milanovviktorio/harbor-measuring-device-SPRO3/README.md

# harbor-measuring-device-SPRO3
SPRO3, SDU Electronics
