milanovviktorio/harbor-measuring-device-SPRO3/Hardware/ESC and BMS/ESC_BMS/DXF_ESCBMS.dxf

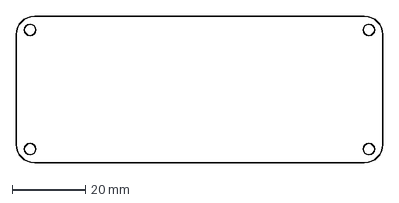
[picture p1: CAD file, 2025-11-08]
Hardware/ESC and BMS/ESC_BMS/DXF_ESCBMS.dxf
100.0 x 40.0 mm
