milanovviktorio/harbor-measuring-device-SPRO3/Hardware/Main_PCB/UJC-HP-3-SMT-TR.step

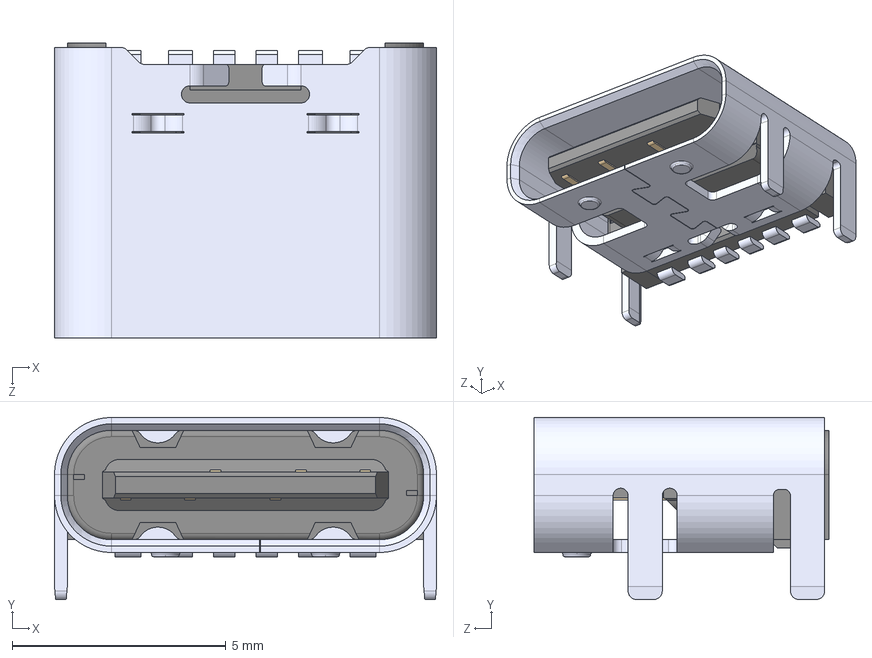
[picture p2: CAD file, 2025-11-06]
Hardware/Main_PCB/UJC-HP-3-SMT-TR.step
8.94 x 4.26 x 6.90 mm
