milanovviktorio/harbor-measuring-device-SPRO3/Hardware/Main_PCB/SRR6038-100Y.step

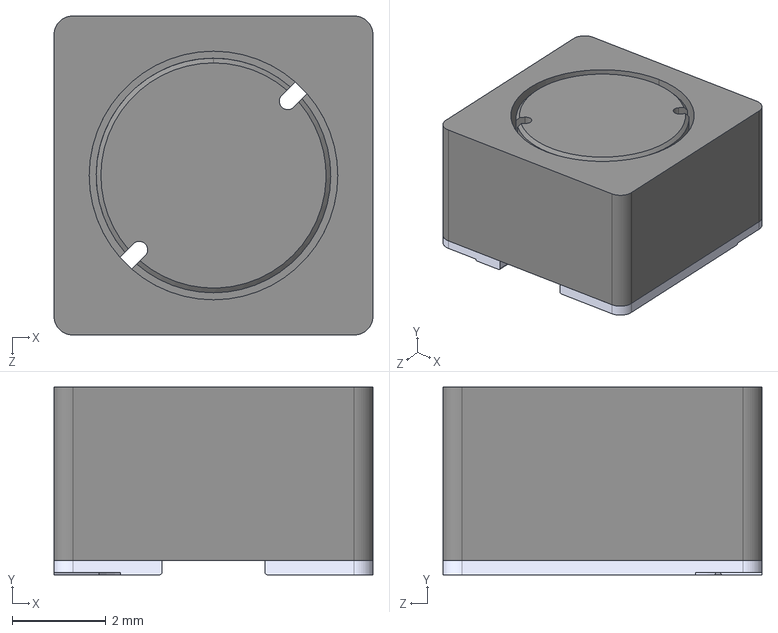
[picture p3: CAD file, 2025-10-28]
Hardware/Main_PCB/SRR6038-100Y.step
6.80 x 4.00 x 6.80 mm
