milanovviktorio/harbor-measuring-device-SPRO3/Hardware/Main_PCB/ICM-42688-P.step

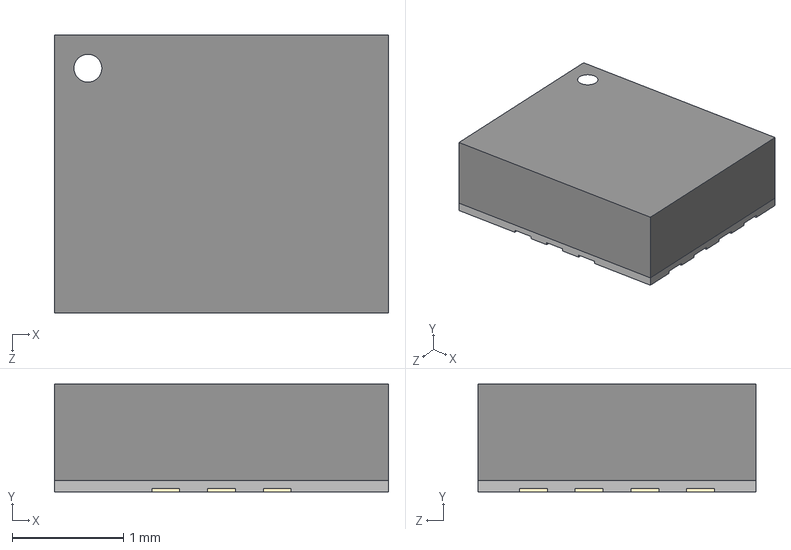
[picture p4: CAD file, 2025-10-21]
Hardware/Main_PCB/ICM-42688-P.step
3.00 x 0.97 x 2.50 mm
