milanovviktorio/harbor-measuring-device-SPRO3/Hardware/Main_PCB/TUSS4470TRTJT.step

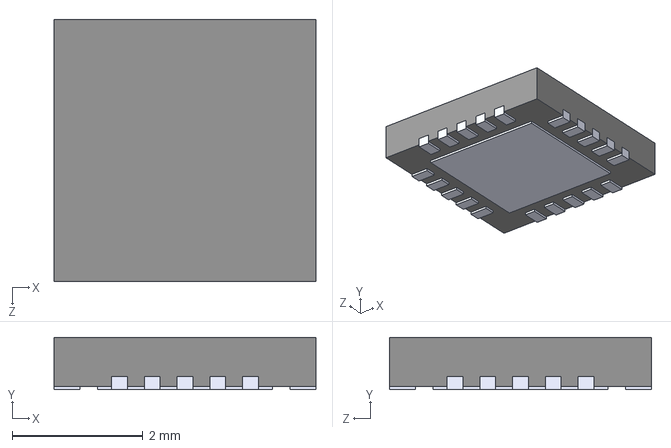
[picture p5: CAD file, 2025-10-21]
Hardware/Main_PCB/TUSS4470TRTJT.step
4.00 x 0.8 x 4.00 mm
