milanovviktorio/harbor-measuring-device-SPRO3/Hardware/Main_PCB/TPS61175PWPR.step

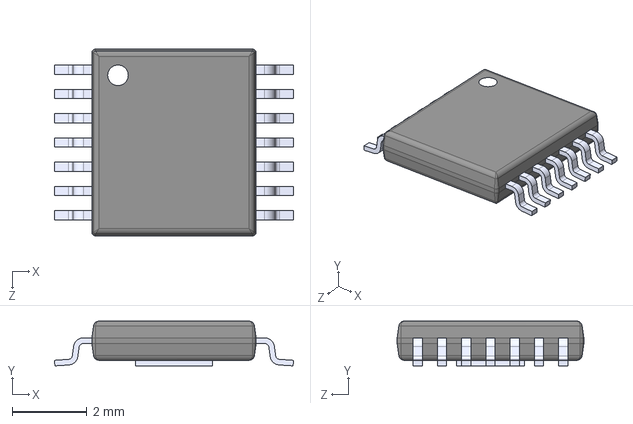
[picture p6: CAD file, 2025-10-22]
Hardware/Main_PCB/TPS61175PWPR.step
6.40 x 1.20 x 5.00 mm
