milanovviktorio/harbor-measuring-device-SPRO3/Hardware/ESC and BMS/ESC_BMS/SPROJ3EE_ESC_BMS.pdf

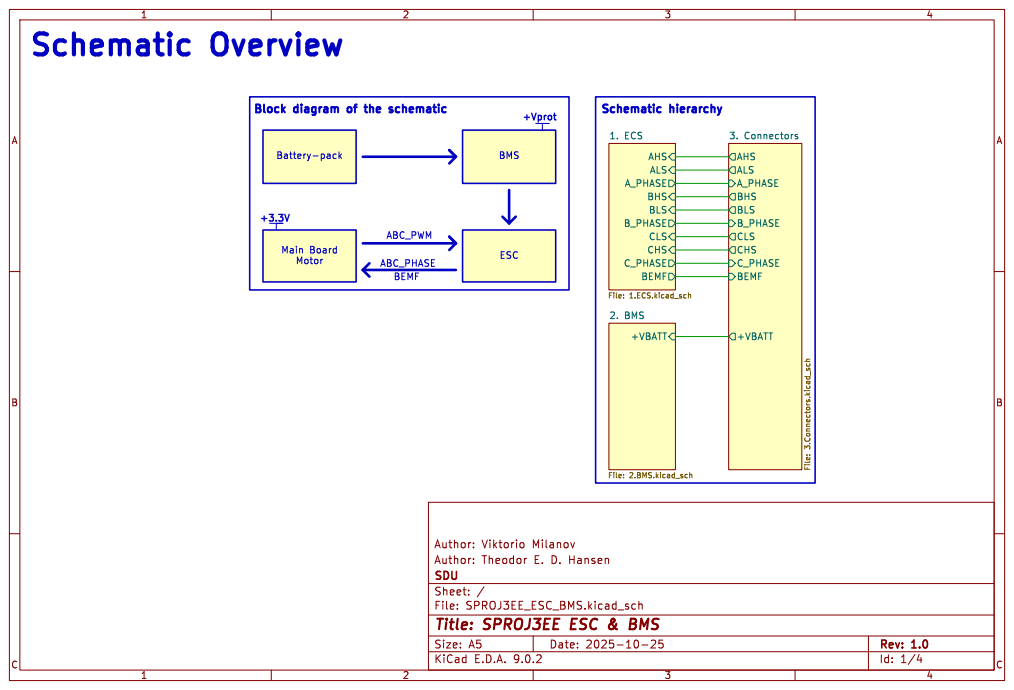
[picture p7: page 1]

Id: 1/4 Title: SPROJ3EE ESC & BMS

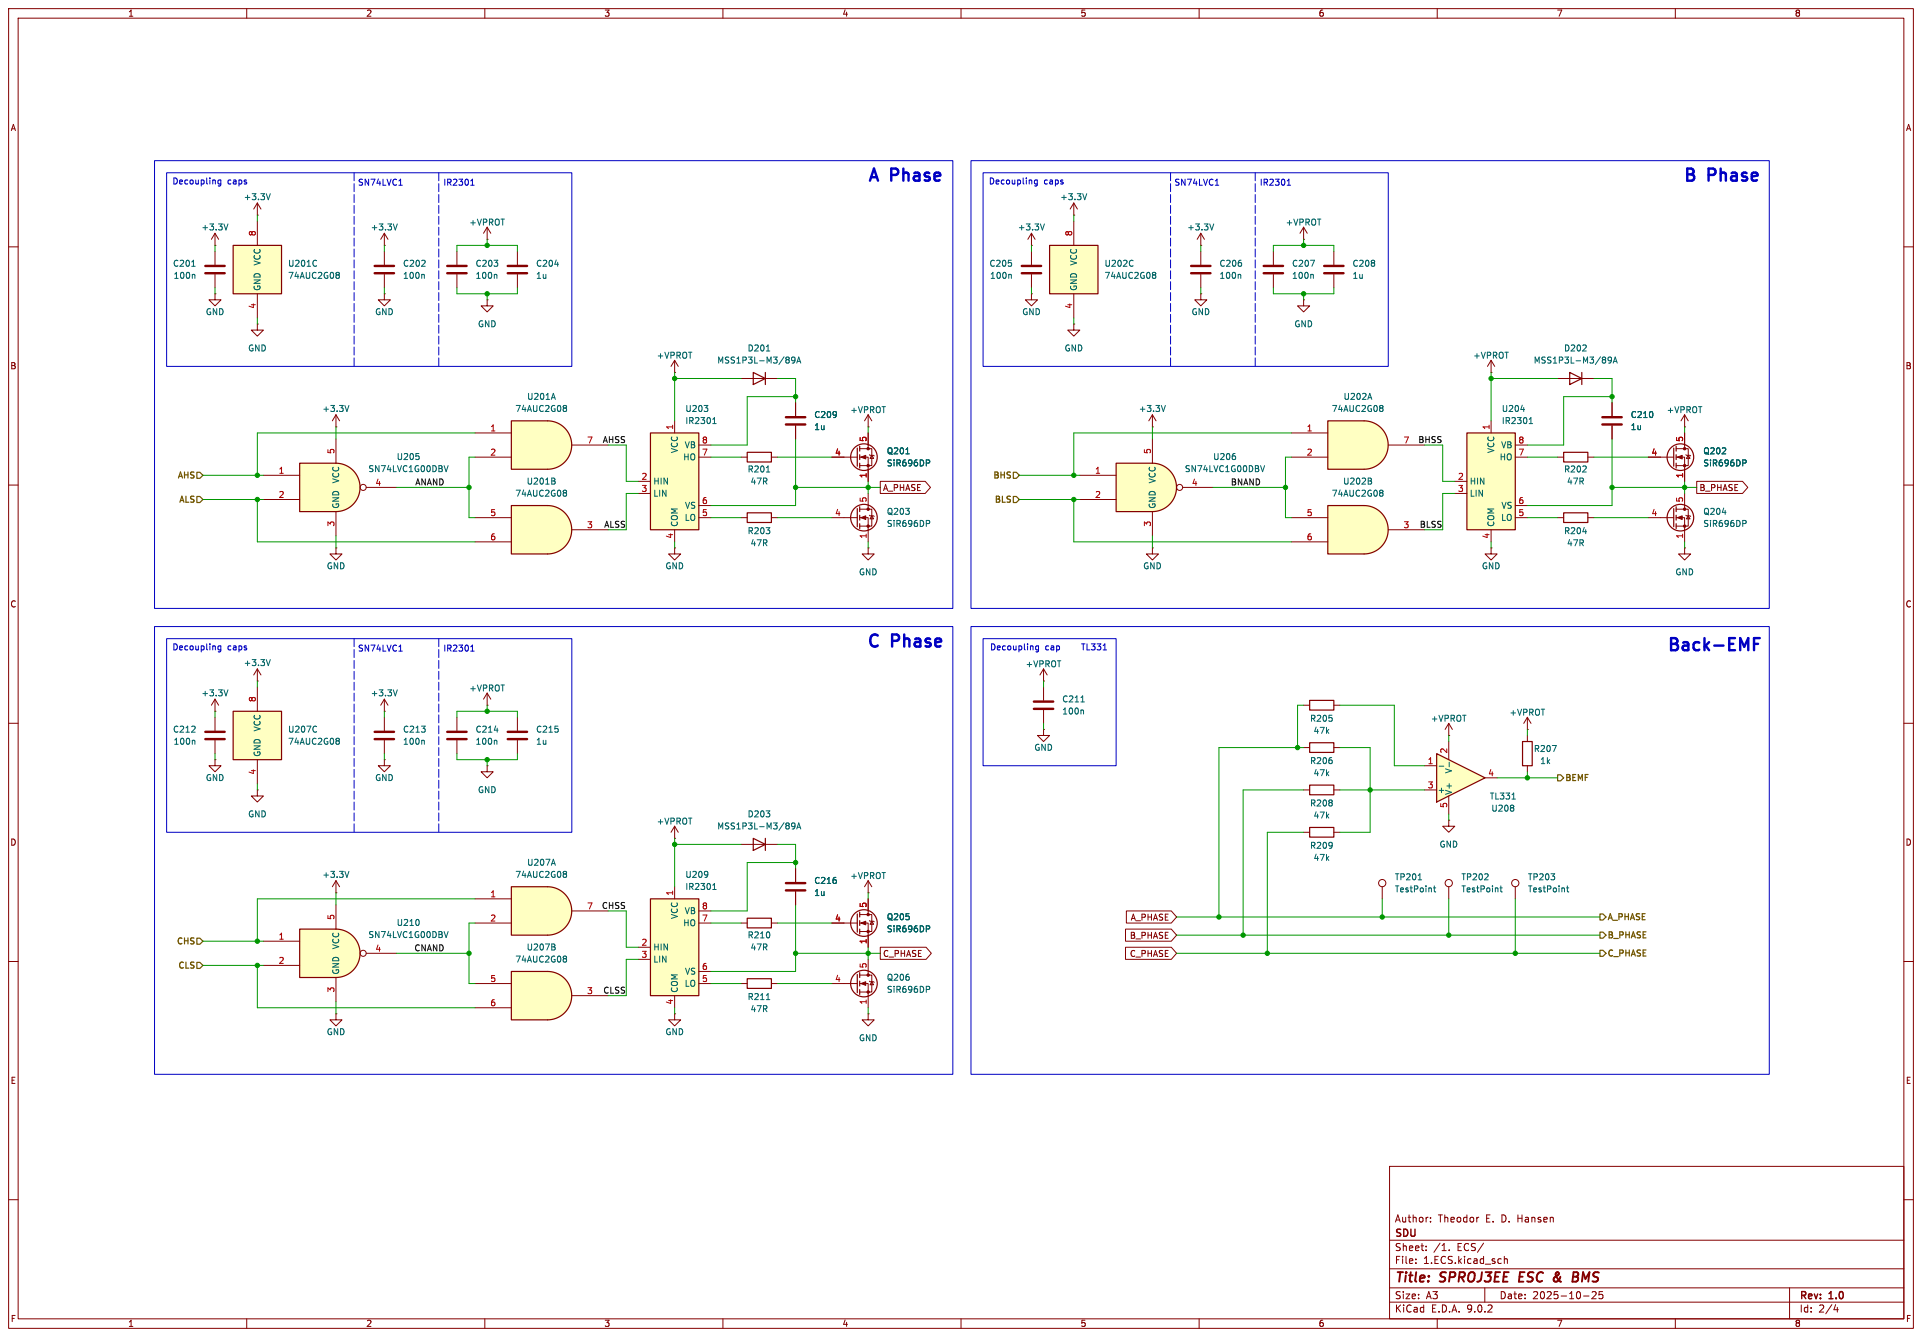
[picture p8: page 2]

Id: 2/4 Title: SPROJ3EE ESC & BMS

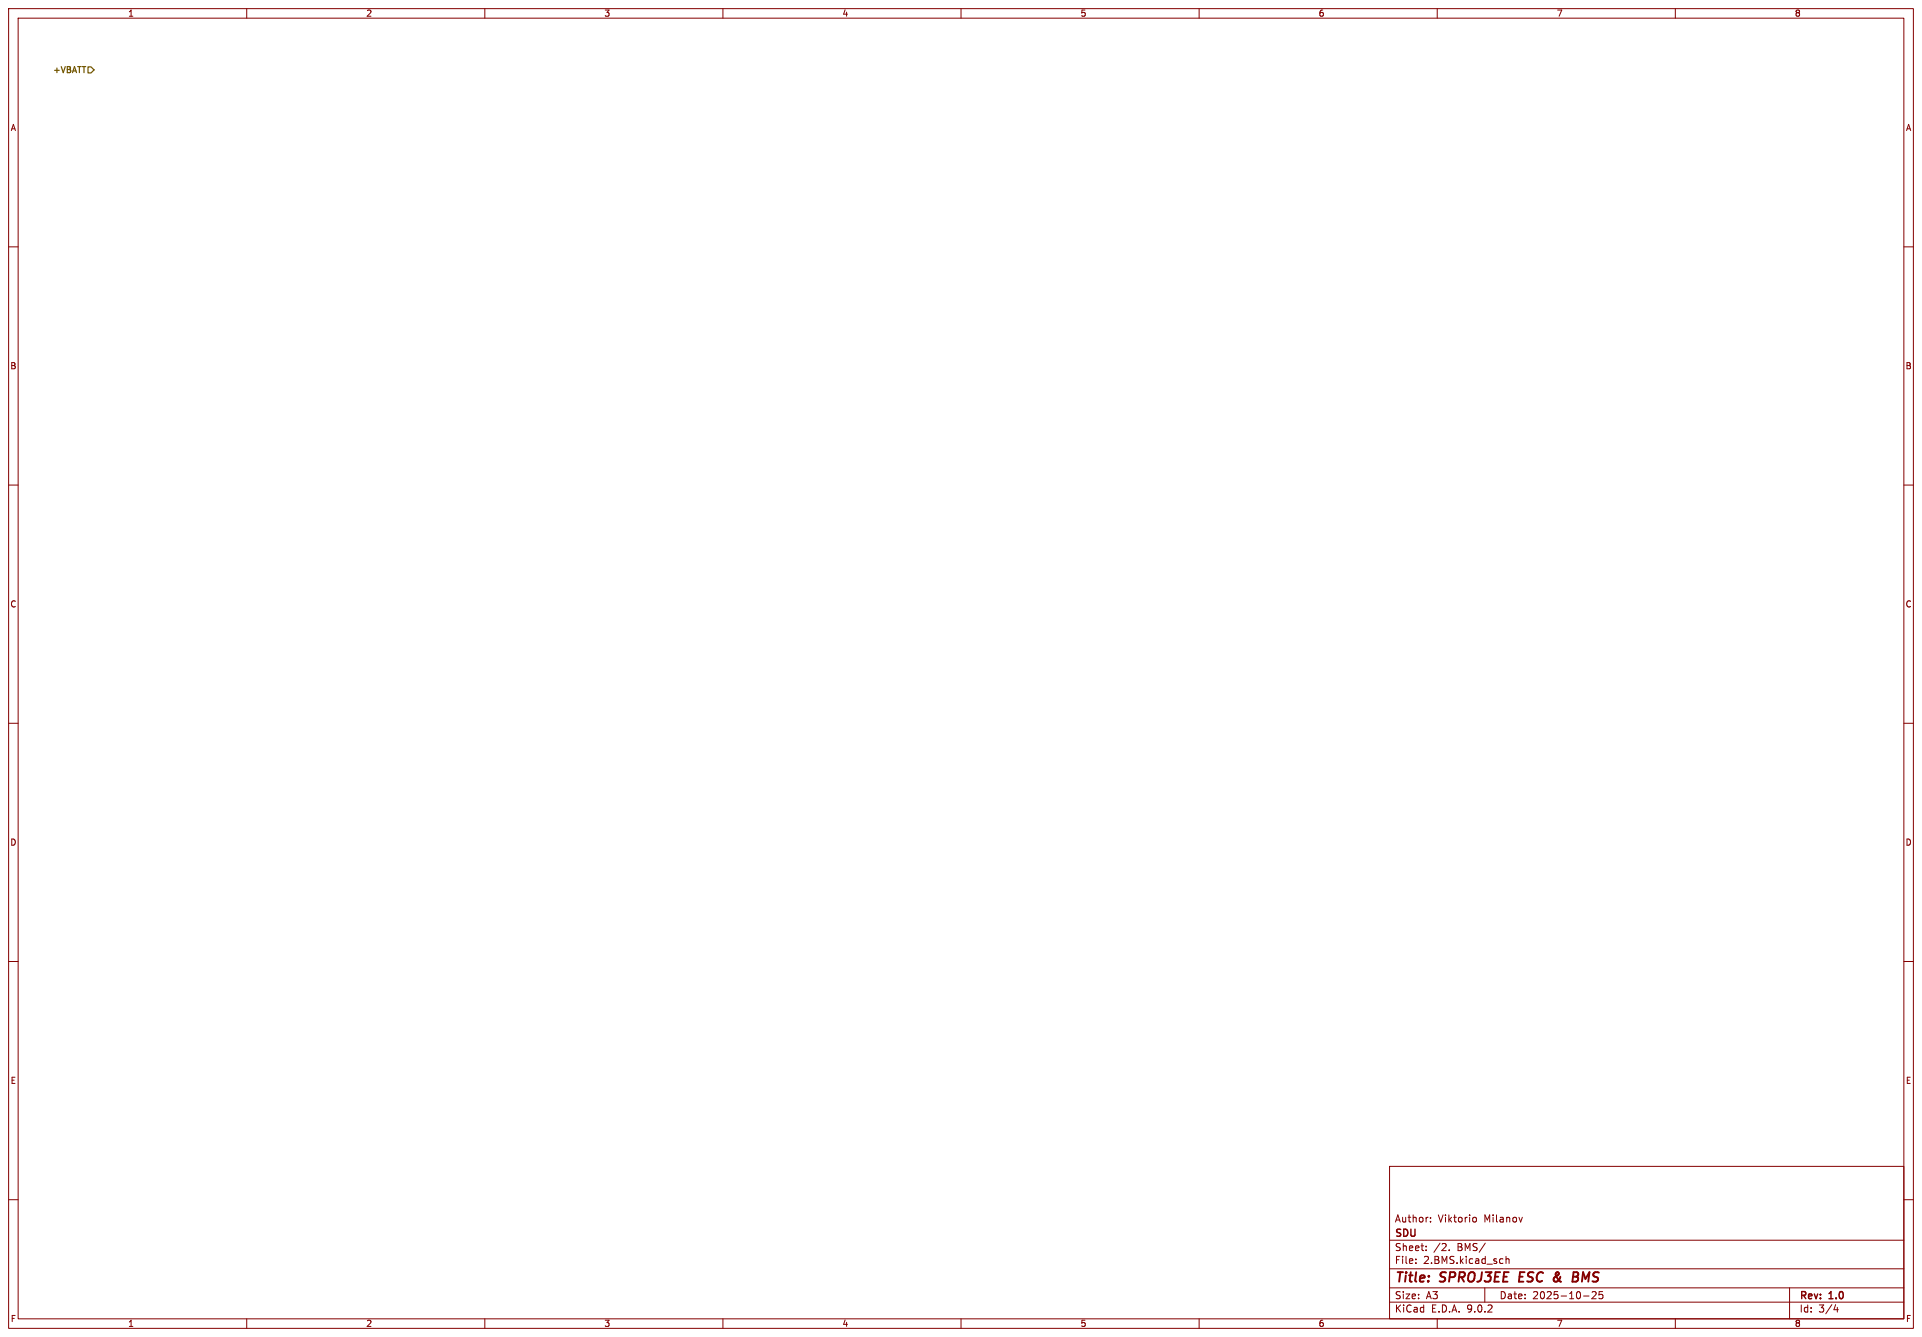
[picture p9: page 3]

Id: 3/4 Title: SPROJ3EE ESC & BMS

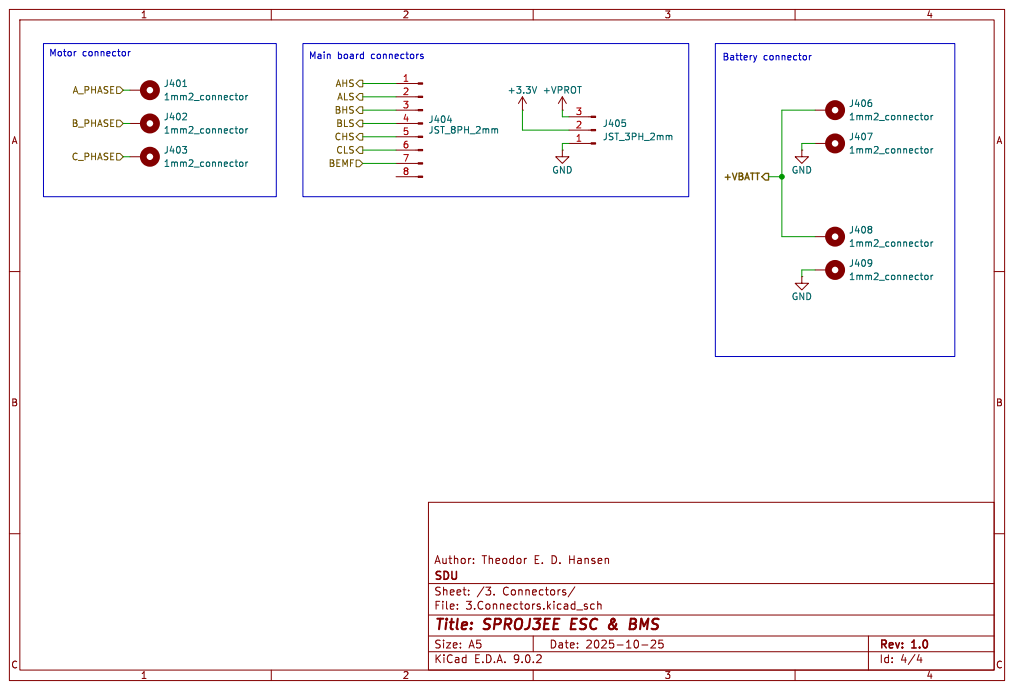
[picture p10: page 4]

File: 3.Connectors.kicad_sch Sheet: /3. Connectors/ SDU

Id: 4/4 Title: SPROJ3EE ESC & BMS
