milanovviktorio/harbor-measuring-device-SPRO3/Simulations/ESC_BMS/RPP/Draft1.asc

C1: cap; 5.3052µ
R1: res; 100
V1: voltage; ""; AC 5
Named nets: 0
.ac oct 100 1 1e9
