milanovviktorio/harbor-measuring-device-SPRO3/Simulations/ESC_BMS/RPP/Rpp.asc

C1: cap; 100n
D1: zener
M1: pmos
R1: res; 27k
V1: voltage; -8.4
Named nets: 0, Vout, Vin
.tran 0 1 0 0.01
