milanovviktorio/harbor-measuring-device-SPRO3/(list of files, drawings)

Other design files:
Simulations/ESC_BMS/SLVMB85A/TPS259260_PSPICE_TRANS/TPS259260_TRANS.DSN
Simulations/ESC_BMS/SLVMB85A/TPS259260_PSPICE_TRANS/TPS259260_TRANS.OPJ
Simulations/ESC_BMS/SLVMB85A/TPS259260_PSPICE_TRANS/TPS259260DRC_TRANS.OLB
