milanovviktorio/harbor-measuring-device-SPRO3/Hardware/RC thing/RC thing.kicad_pcb

## KiCad design Hardware/RC thing/RC thing.kicad_pcb (2025-11-18)

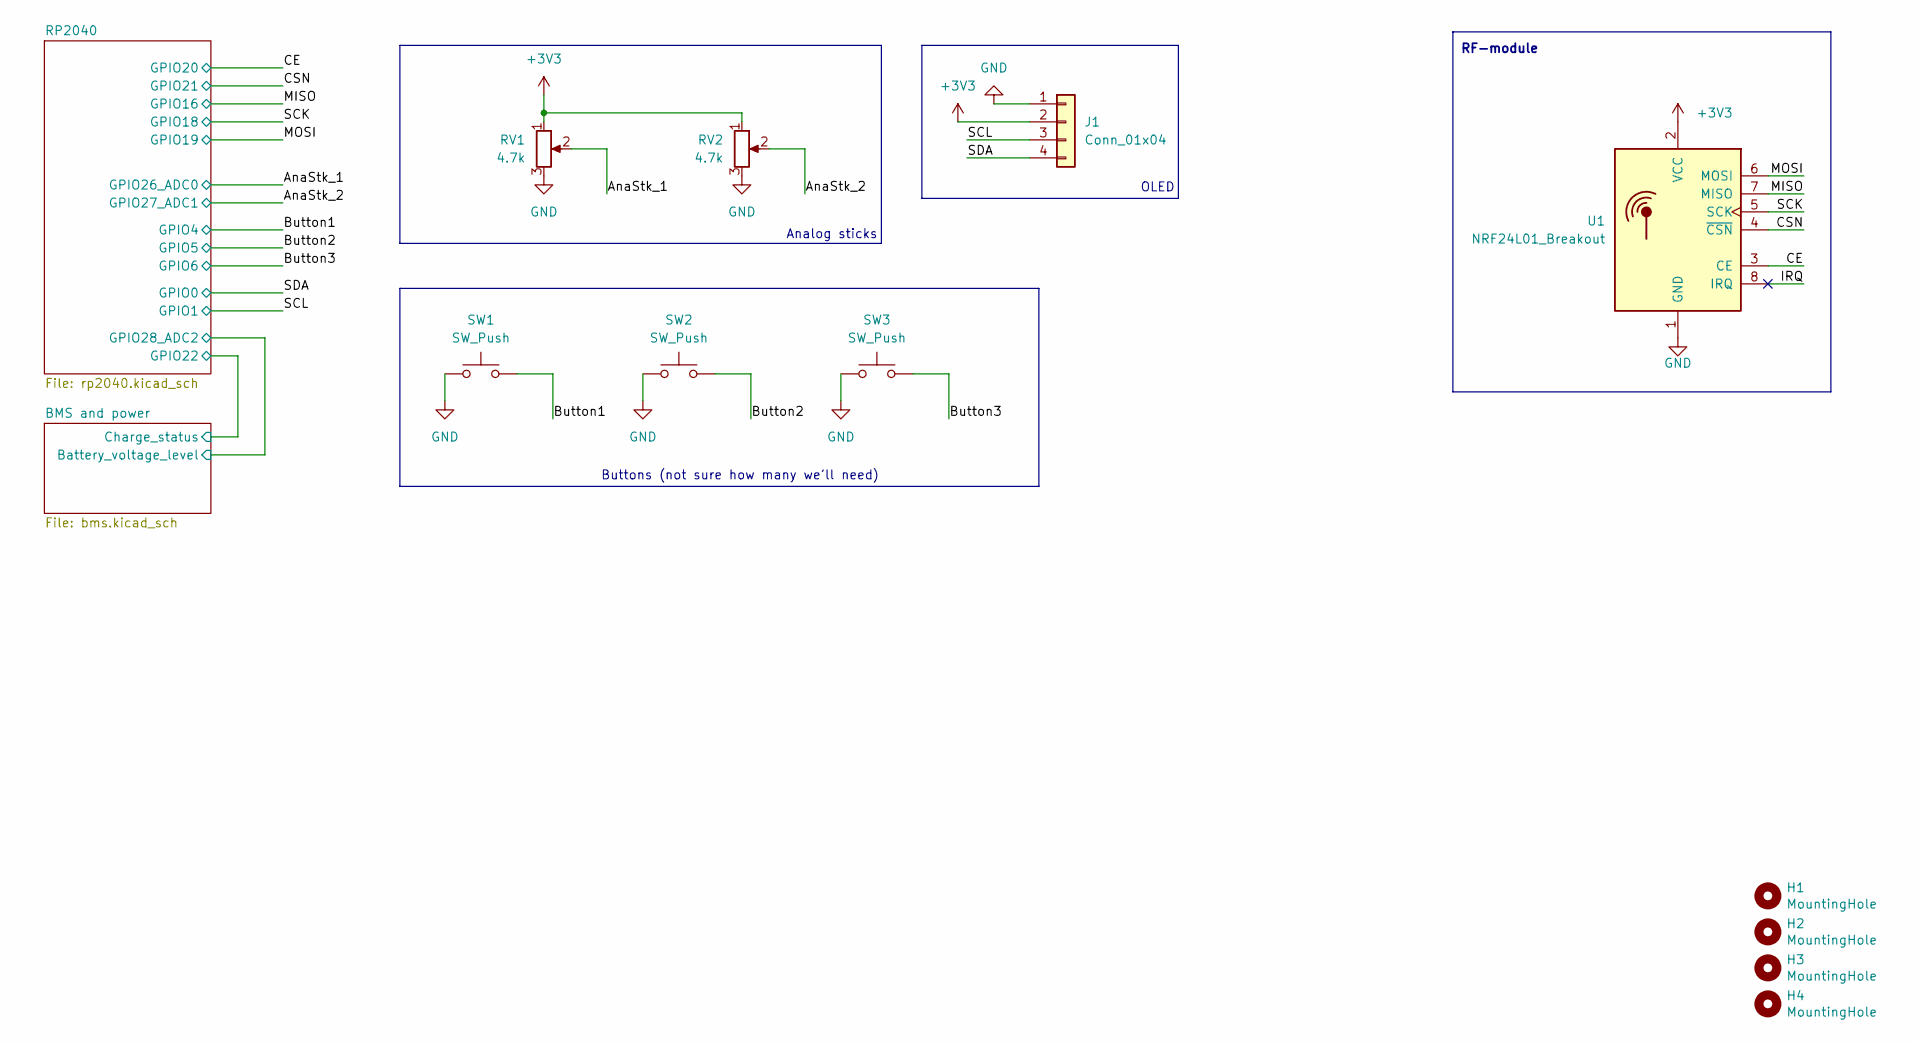
[picture p11: schematic RC thing.kicad_sch, SPRO3D RC remote PCB]

Parts:
H1, H2, H3, H4: MountingHole; MountingHole_2.7mm_M2.5
J1: Conn_01x04; JST_PH_B4B-PH-K_1x04_P2.00mm_Vertical
RV1, RV2: 4.7k; JST_PH_B3B-PH-K_1x03_P2.00mm_Vertical
SW1, SW2, SW3: SW_Push; JST_PH_B2B-PH-K_1x02_P2.00mm_Vertical
U1: NRF24L01_Breakout; PinHeader_2x04_P2.54mm_Vertical

Connections:
+3V3: J1.2, RV1.1, RV2.1, U1.2 (VCC); also elsewhere on the board
/AnaStk_1: RV1.2; also elsewhere on the board
/AnaStk_2: RV2.2; also elsewhere on the board
/Button1: SW1.2; also elsewhere on the board
/Button2: SW2.2; also elsewhere on the board
/Button3: SW3.2; also elsewhere on the board
/CE: U1.3 (CE); also elsewhere on the board
/CSN: U1.4 (~CSN); also elsewhere on the board
/IRQ: U1.8 (IRQ)
/MISO: U1.7 (MISO); also elsewhere on the board
/MOSI: U1.6 (MOSI); also elsewhere on the board
/SCK: U1.5 (SCK); also elsewhere on the board
/SCL: J1.3; also elsewhere on the board
/SDA: J1.4; also elsewhere on the board
GND: J1.1, RV1.3, RV2.3, SW1.1, SW2.1, SW3.1, U1.1 (GND); also elsewhere on the board

Notes on the sheet:
Buttons (not sure how many we'll need)
RF-module
OLED
Analog sticks

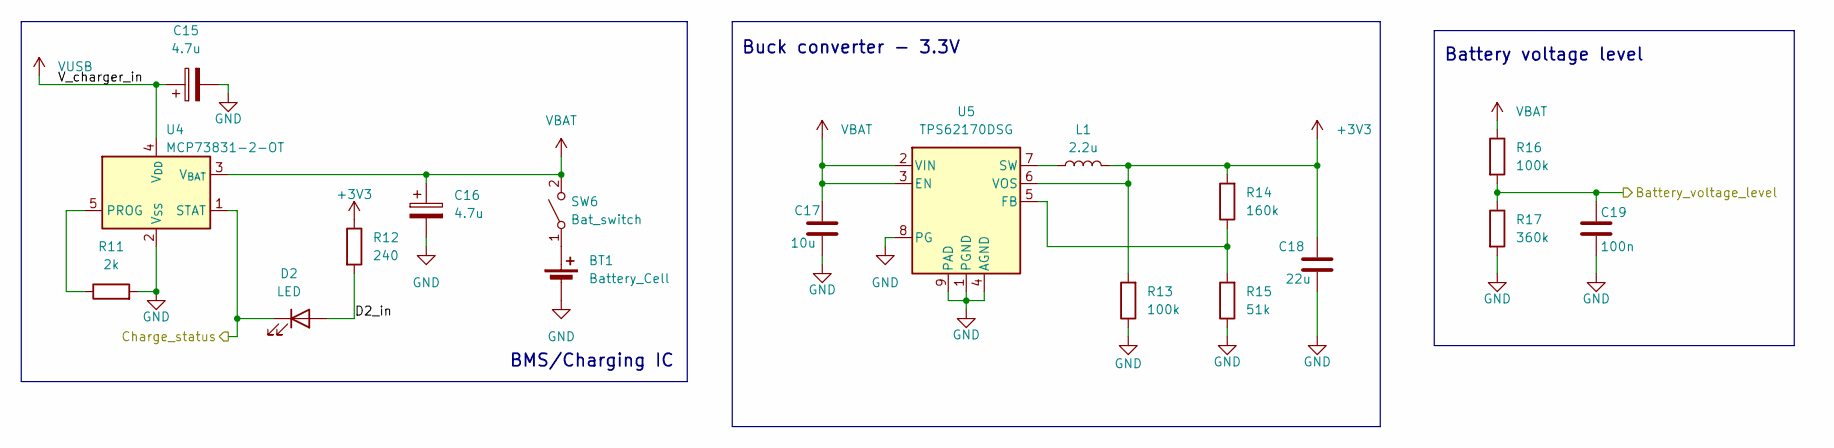
[picture p12: schematic bms.kicad_sch]

Parts:
BT1: Battery_Cell; JST_PH_B2B-PH-K_1x02_P2.00mm_Vertical
C15, C16: 4.7u; C_0805_2012Metric_Pad1.18x1.45mm_HandSolder
C17: 10u; C_0805_2012Metric_Pad1.18x1.45mm_HandSolder
C18: 22u; C_0805_2012Metric_Pad1.18x1.45mm_HandSolder
C19: 100n; C_0603_1608Metric_Pad1.08x0.95mm_HandSolder
D2: LED; D_0603_1608Metric_Pad1.05x0.95mm_HandSolder
L1: 2.2u; L_APV_ANR252012
R11: 2k; R_0603_1608Metric_Pad0.98x0.95mm_HandSolder
R12: 240; R_0603_1608Metric_Pad0.98x0.95mm_HandSolder
R13, R16: 100k; R_0603_1608Metric_Pad0.98x0.95mm_HandSolder
R14: 160k; R_0603_1608Metric_Pad0.98x0.95mm_HandSolder
R15: 51k; R_0603_1608Metric_Pad0.98x0.95mm_HandSolder
R17: 360k; R_0603_1608Metric_Pad0.98x0.95mm_HandSolder
SW6: Bat_switch; JST_PH_B2B-PH-K_1x02_P2.00mm_Vertical
U4: MCP73831-2-OT; SOT-23-5
U5: TPS62170DSG; WSON-8-1EP_2x2mm_P0.5mm_EP0.9x1.6mm_ThermalVias

Connections:
+3V3: C18.1, L1.2, R12.1, R13.2, R14.2, U5.6 (VOS); also elsewhere on the board
/BMS and power/D2_in: D2.2 (A), R12.2
/RP2040/GPIO22: D2.1 (K), U4.1 (STAT); also elsewhere on the board
/RP2040/GPIO28_ADC2: C19.1, R16.2, R17.1; also elsewhere on the board
GND: BT1.2 (-), C15.2, C16.2, C17.2, C18.2, C19.2, R11.2, R13.1, R15.1, R17.2, U4.2 (V_{SS}), U5.1 (PGND), U5.4 (AGND), U5.8 (PG), U5.9 (PAD); also elsewhere on the board
unnamed: BT1.1 (+), SW6.1 (A)
unnamed: R11.1, U4.5 (PROG)
unnamed: R14.1, R15.2, U5.5 (FB)
unnamed: L1.1, U5.7 (SW)
VBAT: C16.1, C17.1, R16.1, SW6.2 (B), U4.3 (V_{BAT}), U5.2 (VIN), U5.3 (EN)
VUSB: C15.1, U4.4 (V_{DD}); also elsewhere on the board

Notes on the sheet:
BMS/Charging IC
Battery voltage level
Buck converter - 3.3V

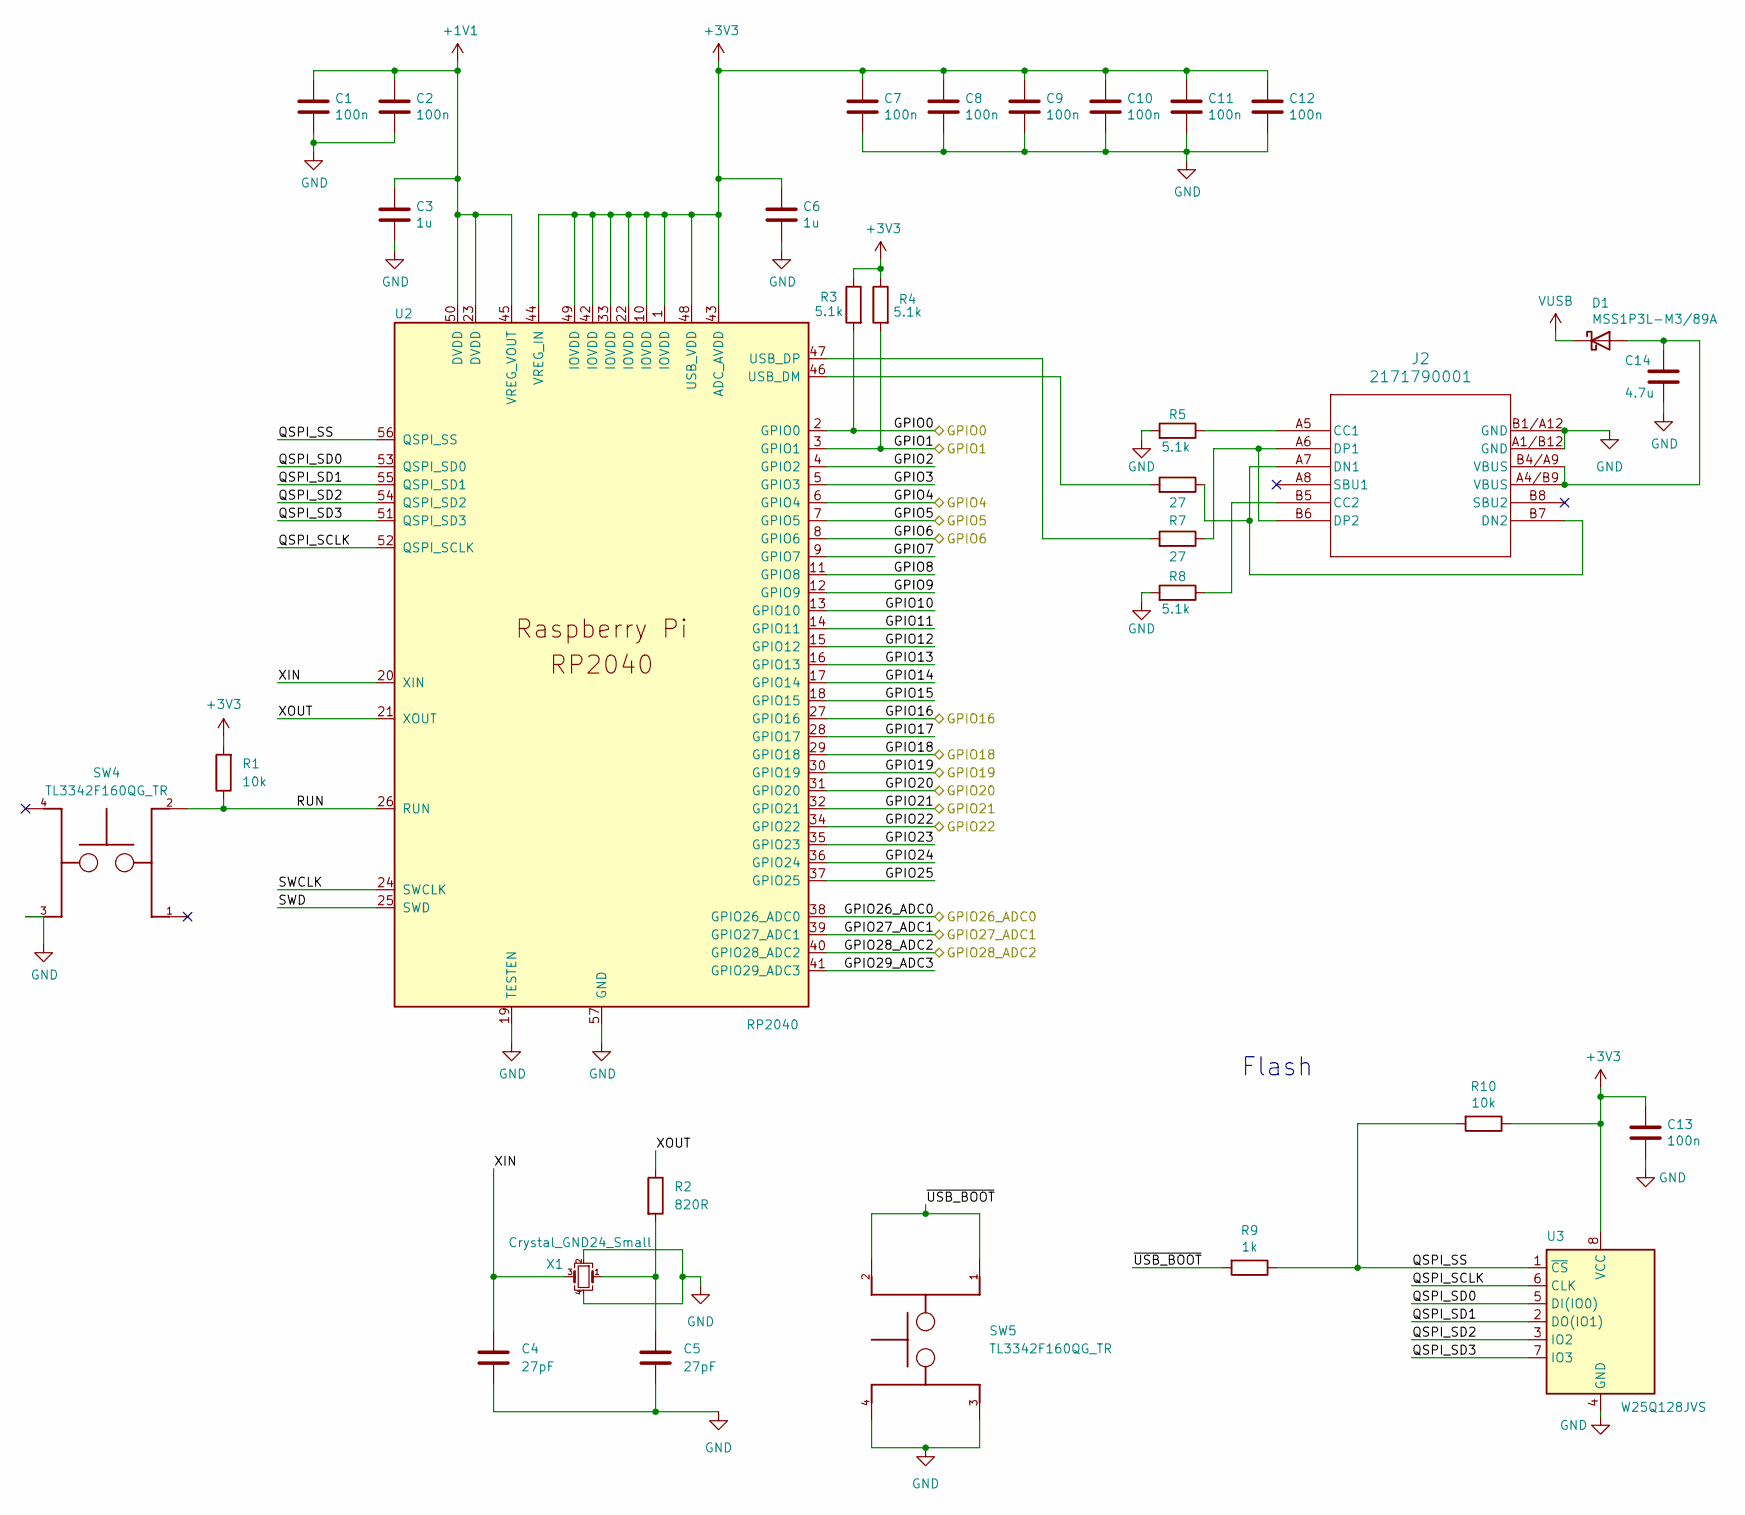
[picture p13: schematic rp2040.kicad_sch, RP2040 Minimal Design Example]

Parts:
C1, C2, C7, C8, C9, C10, C11, C12, C13: 100n; C_0603_1608Metric_Pad1.08x0.95mm_HandSolder
C3, C6: 1u; C_0603_1608Metric_Pad1.08x0.95mm_HandSolder
C4, C5: 27pF; C_0603_1608Metric_Pad1.08x0.95mm_HandSolder
C14: 4.7u; C_0603_1608Metric_Pad1.08x0.95mm_HandSolder
D1: MSS1P3L-M3/89A; Vishay_SMPA
J2: 2171790001; 2171790001_MOL
R1: 10k; C_0603_1608Metric_Pad1.08x0.95mm_HandSolder
R2: 820R; R_0603_1608Metric_Pad0.98x0.95mm_HandSolder
R3, R4, R5, R8: 5.1k; R_0603_1608Metric_Pad0.98x0.95mm_HandSolder
R6, R7: 27; R_0603_1608Metric_Pad0.98x0.95mm_HandSolder
R9: 1k; R_0603_1608Metric_Pad0.98x0.95mm_HandSolder
R10: 10k; R_0603_1608Metric_Pad0.98x0.95mm_HandSolder
SW4, SW5: TL3342F160QG_TR; SW_TL3342F160QG_TR
U2: RP2040; QFN-56-1EP_7x7mm_P0.4mm_EP3.2x3.2mm
U3: W25Q128JVS; SOIC-8_5.3x5.3mm_P1.27mm
X1: Crystal_GND24_Small; Crystal_SMD_Abracon_ABM8G-4Pin_3.2x2.5mm

Connections:
+1V1: C1.1, C2.1, C3.1, U2.23 (DVDD), U2.45 (VREG_VOUT), U2.50 (DVDD)
+3V3: C6.1, C7.1, C8.1, C9.1, C10.1, C11.1, C12.1, C13.1, R1.2, R3.1, R4.1, R10.1, U2.1 (IOVDD), U2.10 (IOVDD), U2.22 (IOVDD), U2.33 (IOVDD), U2.42 (IOVDD), U2.43 (ADC_AVDD), U2.44 (VREG_IN), U2.48 (USB_VDD), U2.49 (IOVDD), U3.8 (VCC); also elsewhere on the board
/AnaStk_1: U2.38 (GPIO26_ADC0); also elsewhere on the board
/AnaStk_2: U2.39 (GPIO27_ADC1); also elsewhere on the board
/Button1: U2.6 (GPIO4); also elsewhere on the board
/Button2: U2.7 (GPIO5); also elsewhere on the board
/Button3: U2.8 (GPIO6); also elsewhere on the board
/CE: U2.31 (GPIO20); also elsewhere on the board
/CSN: U2.32 (GPIO21); also elsewhere on the board
/MISO: U2.27 (GPIO16); also elsewhere on the board
/MOSI: U2.30 (GPIO19); also elsewhere on the board
/RP2040/GPIO2: U2.4 (GPIO2)
/RP2040/GPIO3: U2.5 (GPIO3)
/RP2040/GPIO7: U2.9 (GPIO7)
/RP2040/GPIO8: U2.11 (GPIO8)
/RP2040/GPIO9: U2.12 (GPIO9)
/RP2040/GPIO10: U2.13 (GPIO10)
/RP2040/GPIO11: U2.14 (GPIO11)
/RP2040/GPIO12: U2.15 (GPIO12)
/RP2040/GPIO13: U2.16 (GPIO13)
/RP2040/GPIO14: U2.17 (GPIO14)
/RP2040/GPIO15: U2.18 (GPIO15)
/RP2040/GPIO17: U2.28 (GPIO17)
/RP2040/GPIO22: U2.34 (GPIO22); also elsewhere on the board
/RP2040/GPIO23: U2.35 (GPIO23)
/RP2040/GPIO24: U2.36 (GPIO24)
/RP2040/GPIO25: U2.37 (GPIO25)
/RP2040/GPIO28_ADC2: U2.40 (GPIO28_ADC2); also elsewhere on the board
/RP2040/GPIO29_ADC3: U2.41 (GPIO29_ADC3)
/RP2040/QSPI_SCLK: U2.52 (QSPI_SCLK), U3.6 (CLK)
/RP2040/QSPI_SD0: U2.53 (QSPI_SD0), U3.5 (DI(IO0))
/RP2040/QSPI_SD1: U2.55 (QSPI_SD1), U3.2 (DO(IO1))
/RP2040/QSPI_SD2: U2.54 (QSPI_SD2), U3.3 (IO2)
/RP2040/QSPI_SD3: U2.51 (QSPI_SD3), U3.7 (IO3)
/RP2040/QSPI_SS: R9.1, R10.2, U2.56 (QSPI_SS), U3.1 (~CS)
/RP2040/RUN: R1.1, SW4.2, U2.26 (RUN)
/RP2040/SWCLK: U2.24 (SWCLK)
/RP2040/SWD: U2.25 (SWD)
/RP2040/XIN: C4.1, U2.20 (XIN), X1.3
/RP2040/XOUT: R2.1, U2.21 (XOUT)
/RP2040/~USB_BOOT: R9.2, SW5.1, SW5.2
/SCK: U2.29 (GPIO18); also elsewhere on the board
/SCL: R4.2, U2.3 (GPIO1); also elsewhere on the board
/SDA: R3.2, U2.2 (GPIO0); also elsewhere on the board
GND: C1.2, C2.2, C3.2, C4.2, C5.2, C6.2, C7.2, C8.2, C9.2, C10.2, C11.2, C12.2, C13.2, C14.2, J2.A1/B12 (GND), J2.B1/A12 (GND), R5.2, R8.2, SW4.3, SW5.3, SW5.4, U2.19 (TESTEN), U2.57 (GND), U3.4 (GND), X1.2, X1.4; also elsewhere on the board
unnamed: C5.1, R2.2, X1.1
unnamed: C14.1, D1.2 (A), J2.A4/B9 (VBUS), J2.B4/A9 (VBUS)
unnamed: J2.A5 (CC1), R5.1
unnamed: J2.B5 (CC2), R8.1
unnamed: J2.A7 (DN1), J2.B7 (DN2), R6.1
unnamed: J2.A6 (DP1), J2.B6 (DP2), R7.1
unnamed: R6.2, U2.46 (USB_DM)
unnamed: R7.2, U2.47 (USB_DP)
VUSB: D1.1 (K); also elsewhere on the board

Notes on the sheet:
Flash

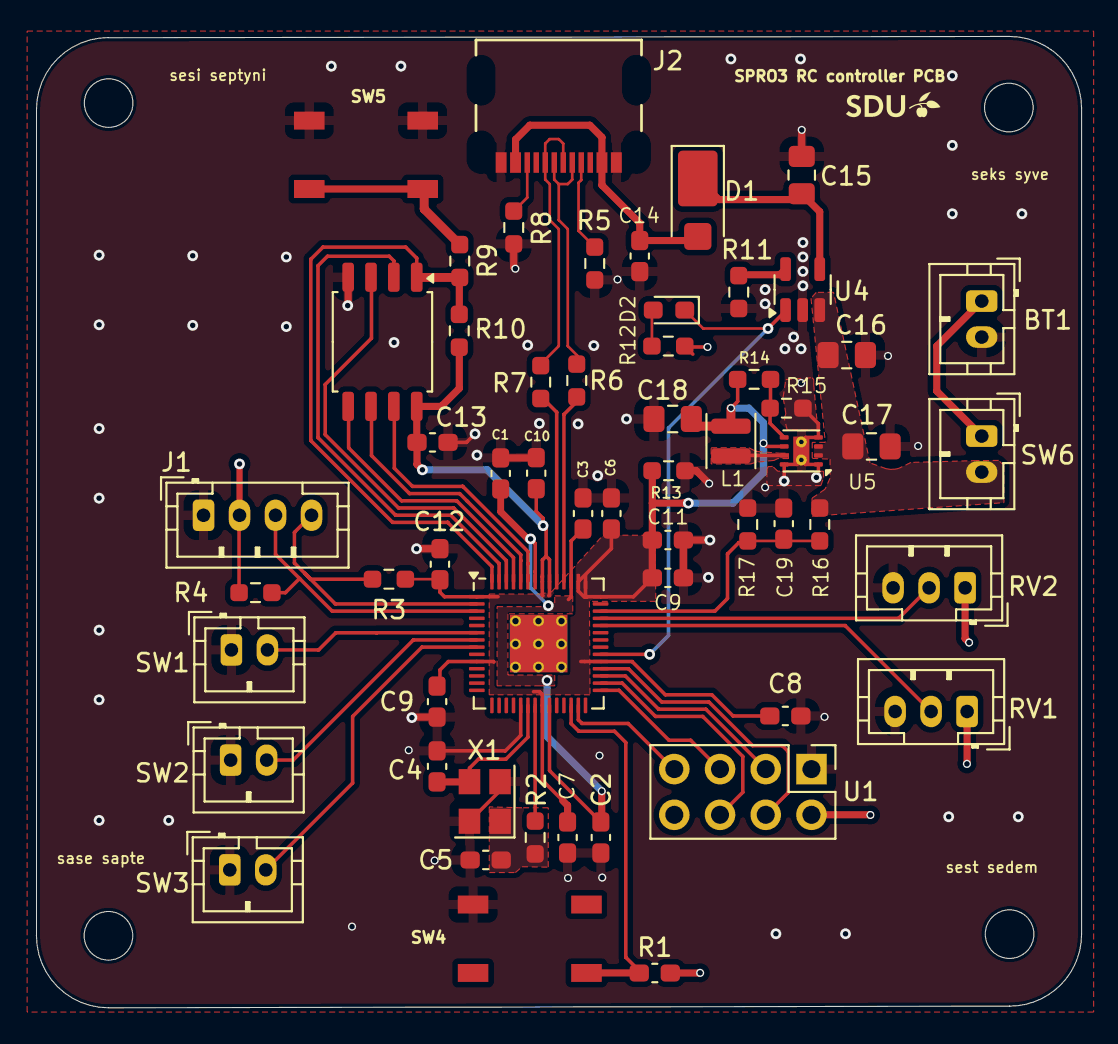
[picture p14: board RC thing.kicad_pcb from above]

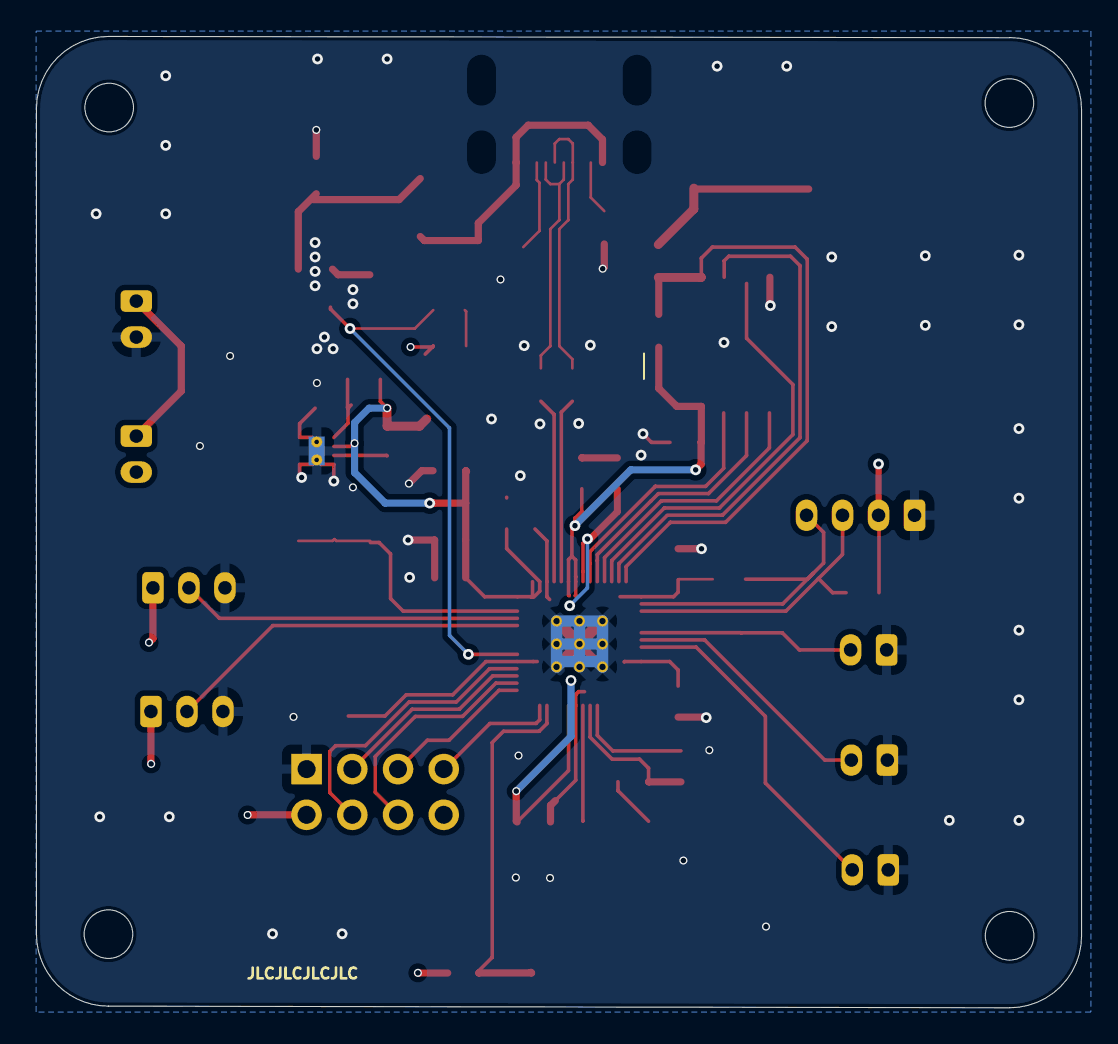
[picture p15: board RC thing.kicad_pcb from below]

Board: 4 copper layers, 58.1 x 54.0 mm, 61 parts (4 on the bottom side), 42 nets.

Other parts of the board:
C9#2: 100nx2; C_0603_1608Metric_Pad1.08x0.95mm_HandSolder

Their connections:
+3V3: C9#2.1; also elsewhere on the board
GND: C9#2.2; also elsewhere on the board
