milanovviktorio/harbor-measuring-device-SPRO3/Hardware/Main_PCB/Main_PCB.kicad_pcb

## KiCad design Hardware/Main_PCB/Main_PCB.kicad_pcb (2025-11-18)

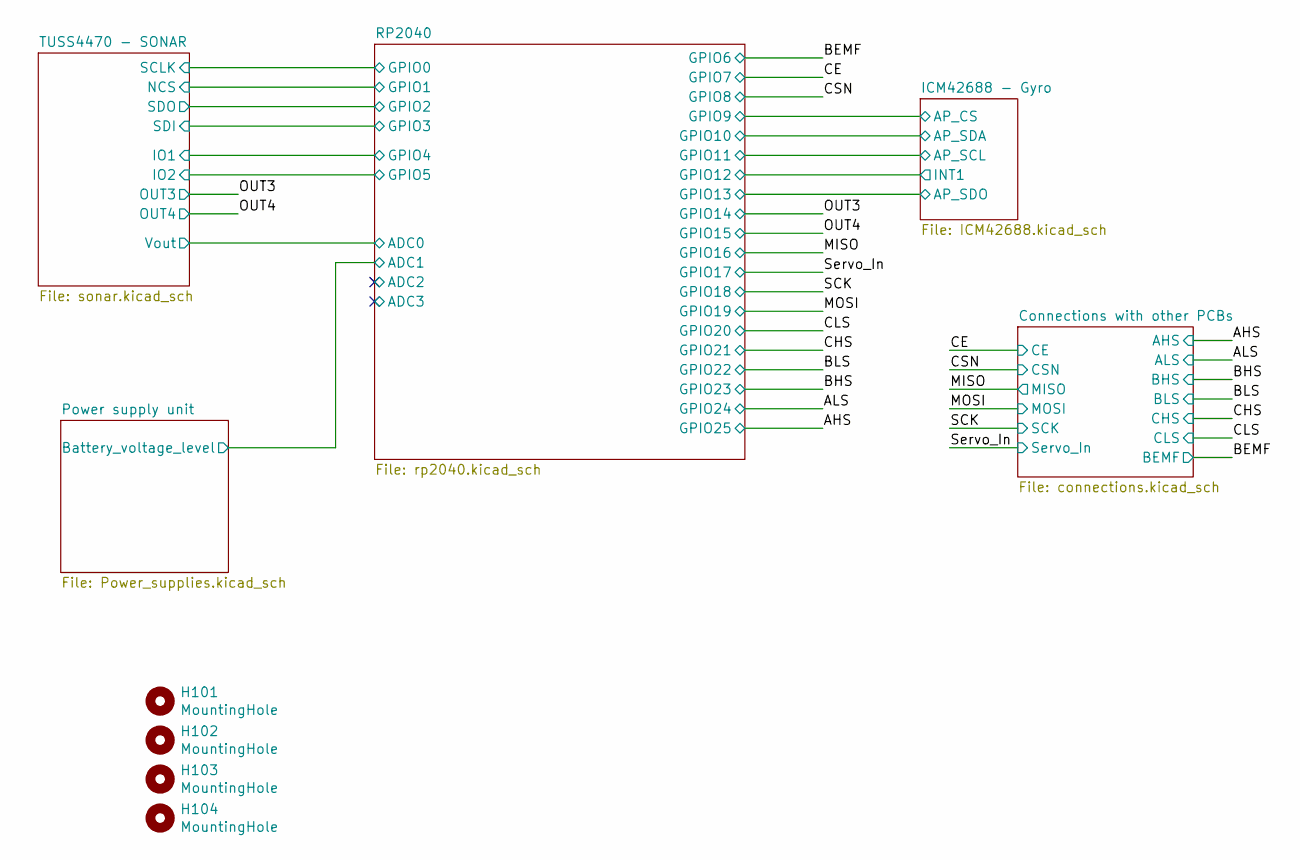
[picture p16: schematic Main_PCB.kicad_sch]

Parts:
H101, H102, H103, H104: MountingHole; MountingHole_2.7mm_M2.5

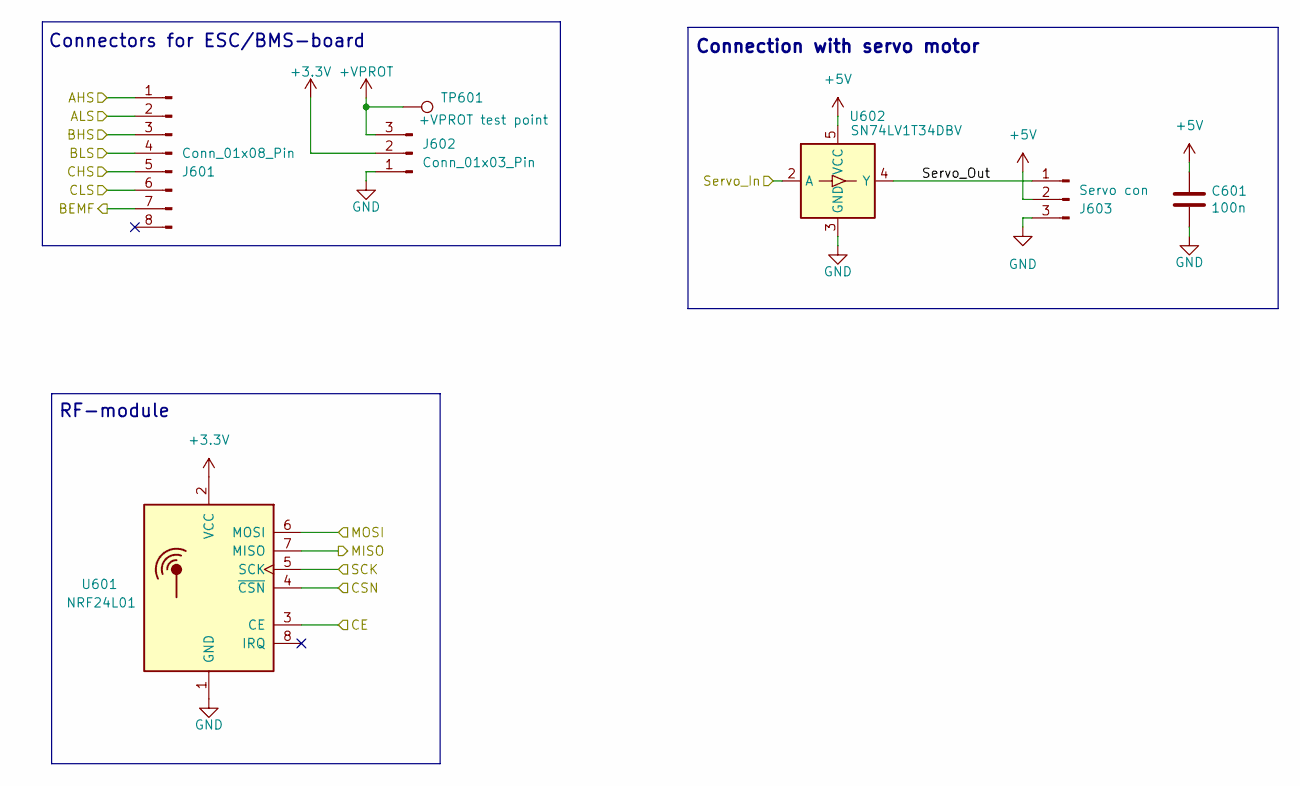
[picture p17: schematic connections.kicad_sch]

Parts:
C601: 100n; C_0603_1608Metric_Pad1.08x0.95mm_HandSolder
J601: Conn_01x08_Pin; JST_PH_B8B-PH-K_1x08_P2.00mm_Vertical
J602: Conn_01x03_Pin; JST_PH_B3B-PH-K_1x03_P2.00mm_Vertical
J603: Servo con; JST_PH_B3B-PH-K_1x03_P2.00mm_Vertical
TP601: +VPROT test point; TestPoint_Pad_D1.0mm
U601: NRF24L01; PinSocket_2x04_P2.54mm_Vertical
U602: SN74LV1T34DBV; SOT-23-5

Connections:
+3.3V: J602.2, U601.2 (VCC); also elsewhere on the board
+5V: C601.1, J603.2, U602.5 (VCC); also elsewhere on the board
+VPROT: J602.3, TP601.1; also elsewhere on the board
/AHS: J601.1; also elsewhere on the board
/ALS: J601.2; also elsewhere on the board
/BEMF: J601.7; also elsewhere on the board
/BHS: J601.3; also elsewhere on the board
/BLS: J601.4; also elsewhere on the board
/CE: U601.3 (CE); also elsewhere on the board
/CHS: J601.5; also elsewhere on the board
/CLS: J601.6; also elsewhere on the board
/CSN: U601.4 (~CSN); also elsewhere on the board
/Connections with other PCBs/Servo_Out: J603.1, U602.4 (Y)
/MISO: U601.7 (MISO); also elsewhere on the board
/MOSI: U601.6 (MOSI); also elsewhere on the board
/SCK: U601.5 (SCK); also elsewhere on the board
/Servo_In: U602.2 (A); also elsewhere on the board
GND: C601.2, J602.1, J603.3, U601.1 (GND), U602.3 (GND); also elsewhere on the board

Notes on the sheet:
Connection with servo motor
RF-module
Connectors for ESC/BMS-board

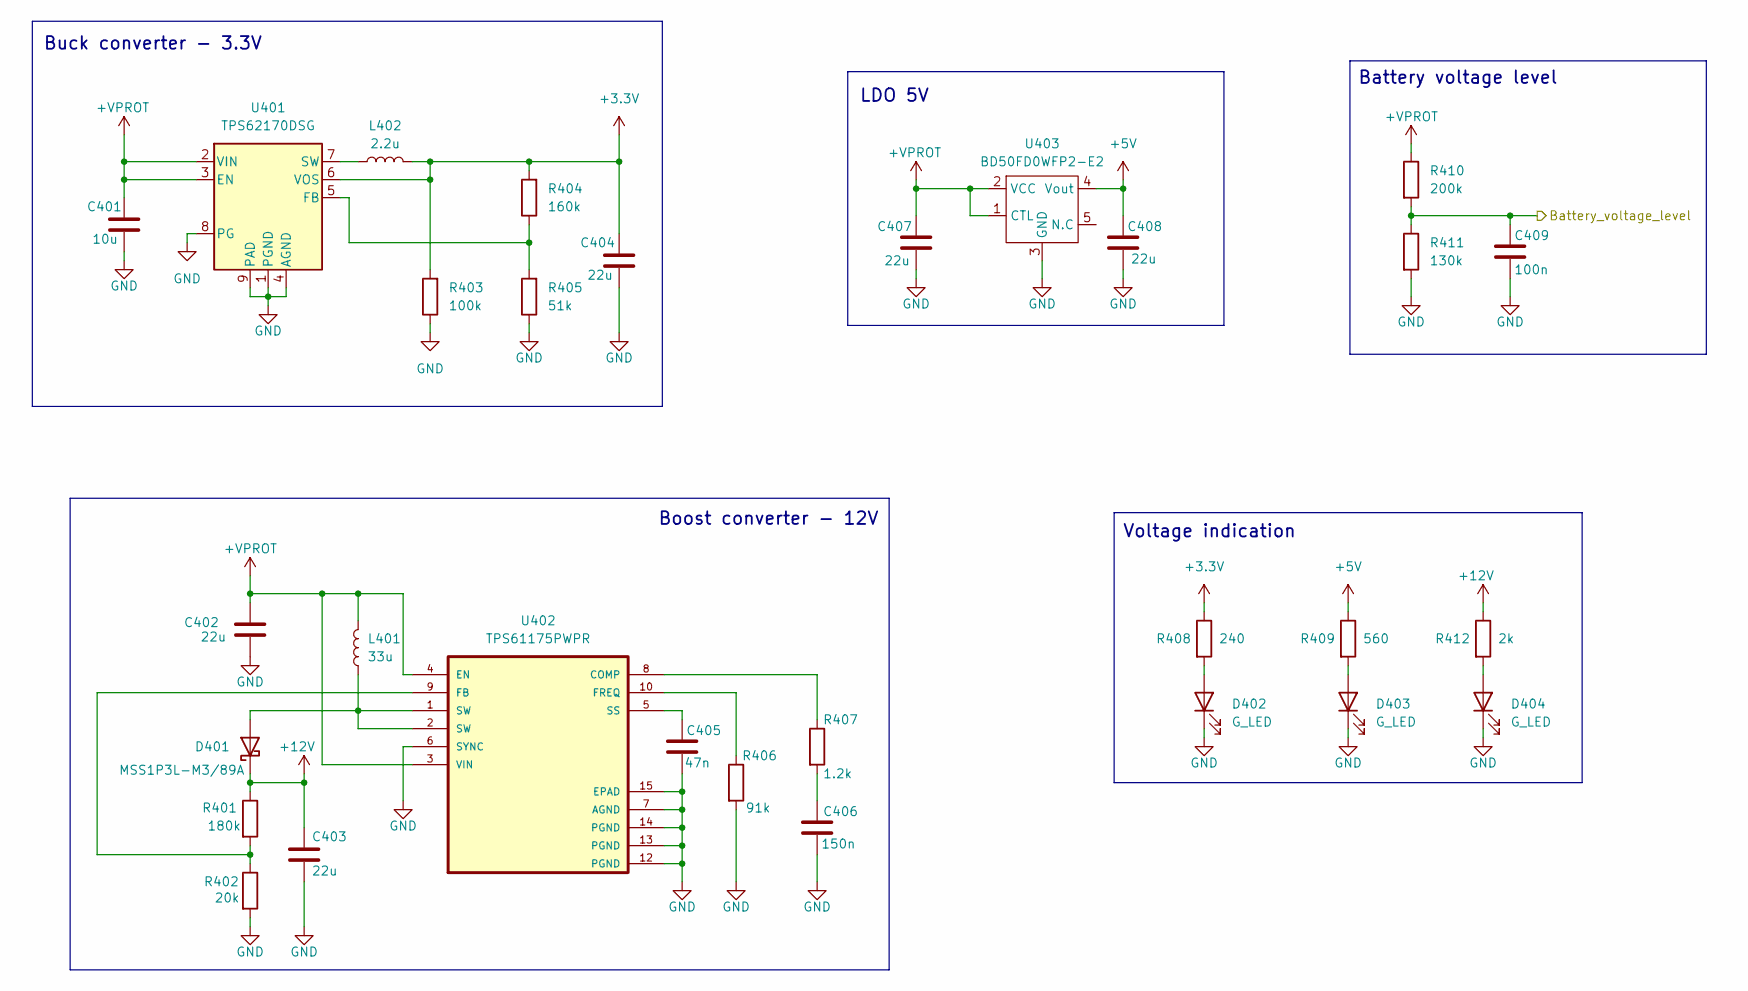
[picture p18: schematic Power_supplies.kicad_sch]

Parts:
C401: 10u; C_0805_2012Metric_Pad1.18x1.45mm_HandSolder
C402, C403, C404, C407, C408: 22u; C_0805_2012Metric_Pad1.18x1.45mm_HandSolder
C405: 47n; C_0805_2012Metric_Pad1.18x1.45mm_HandSolder
C406: 150n; C_0805_2012Metric_Pad1.18x1.45mm_HandSolder
C409: 100n; C_0603_1608Metric_Pad1.08x0.95mm_HandSolder
D401: MSS1P3L-M3/89A; Vishay_SMPA
D402, D403, D404: G_LED; D_0603_1608Metric_Pad1.05x0.95mm_HandSolder
L401: 33u; VLCF4018
L402: 2.2u; L_APV_ANR252012
R401: 180k; R_0603_1608Metric_Pad0.98x0.95mm_HandSolder
R402: 20k; R_0603_1608Metric_Pad0.98x0.95mm_HandSolder
R403: 100k; R_0603_1608Metric_Pad0.98x0.95mm_HandSolder
R404: 160k; R_0603_1608Metric_Pad0.98x0.95mm_HandSolder
R405: 51k; R_0603_1608Metric_Pad0.98x0.95mm_HandSolder
R406: 91k; R_0603_1608Metric_Pad0.98x0.95mm_HandSolder
R407: 1.2k; R_0603_1608Metric_Pad0.98x0.95mm_HandSolder
R408: 240; R_0603_1608Metric_Pad0.98x0.95mm_HandSolder
R409: 560; R_0603_1608Metric_Pad0.98x0.95mm_HandSolder
R410: 200k; R_0603_1608Metric_Pad0.98x0.95mm_HandSolder
R411: 130k; R_0603_1608Metric_Pad0.98x0.95mm_HandSolder
R412: 2k; R_0603_1608Metric_Pad0.98x0.95mm_HandSolder
U401: TPS62170DSG; WSON-8-1EP_2x2mm_P0.5mm_EP0.9x1.6mm_ThermalVias
U402: TPS61175PWPR; IC_TPS27S100BPWPR
U403: BD50FD0WFP2-E2; TO-263-5_TabPin3

Connections:
+3.3V: C404.1, L402.2, R403.2, R404.2, R408.1, U401.6 (VOS); also elsewhere on the board
+5V: C408.1, R409.1, U403.4 (Vout); also elsewhere on the board
+12V: C403.1, D401.1 (K), R401.1, R412.1; also elsewhere on the board
+VPROT: C401.1, C402.2, C407.1, L401.2, R410.1, U401.2 (VIN), U401.3 (EN), U402.3 (VIN), U402.4 (EN), U403.1 (CTL), U403.2 (VCC); also elsewhere on the board
/Power supply unit/Battery_voltage_level: C409.1, R410.2, R411.1; also elsewhere on the board
GND: C401.2, C402.1, C403.2, C404.2, C405.2, C406.2, C407.2, C408.2, C409.2, D402.1 (K), D403.1 (K), D404.1 (K), R402.2, R403.1, R405.1, R406.2, R411.2, U401.1 (PGND), U401.4 (AGND), U401.8 (PG), U401.9 (PAD), U402.6 (SYNC), U402.7 (AGND), U402.12 (PGND), U402.13 (PGND), U402.14 (PGND), U402.15 (EPAD), U403.3 (GND); also elsewhere on the board
unnamed: C406.1, R407.2
unnamed: D401.2 (A), L401.1, U402.1 (SW), U402.2 (SW)
unnamed: D402.2 (A), R408.2
unnamed: D403.2 (A), R409.2
unnamed: D404.2 (A), R412.2
unnamed: R404.1, R405.2, U401.5 (FB)
unnamed: L402.1, U401.7 (SW)
unnamed: R407.1, U402.8 (COMP)
unnamed: R401.2, R402.1, U402.9 (FB)
unnamed: R406.1, U402.10 (FREQ)
unnamed: C405.1, U402.5 (SS)

Notes on the sheet:
Boost converter - 12V
LDO 5V
Buck converter - 3.3V
Voltage indication
Battery voltage level
