milanovviktorio/harbor-measuring-device-SPRO3/Hardware/Main_PCB/Main_PCB.kicad_pcb

## KiCad design Hardware/Main_PCB/Main_PCB.kicad_pcb (continued)

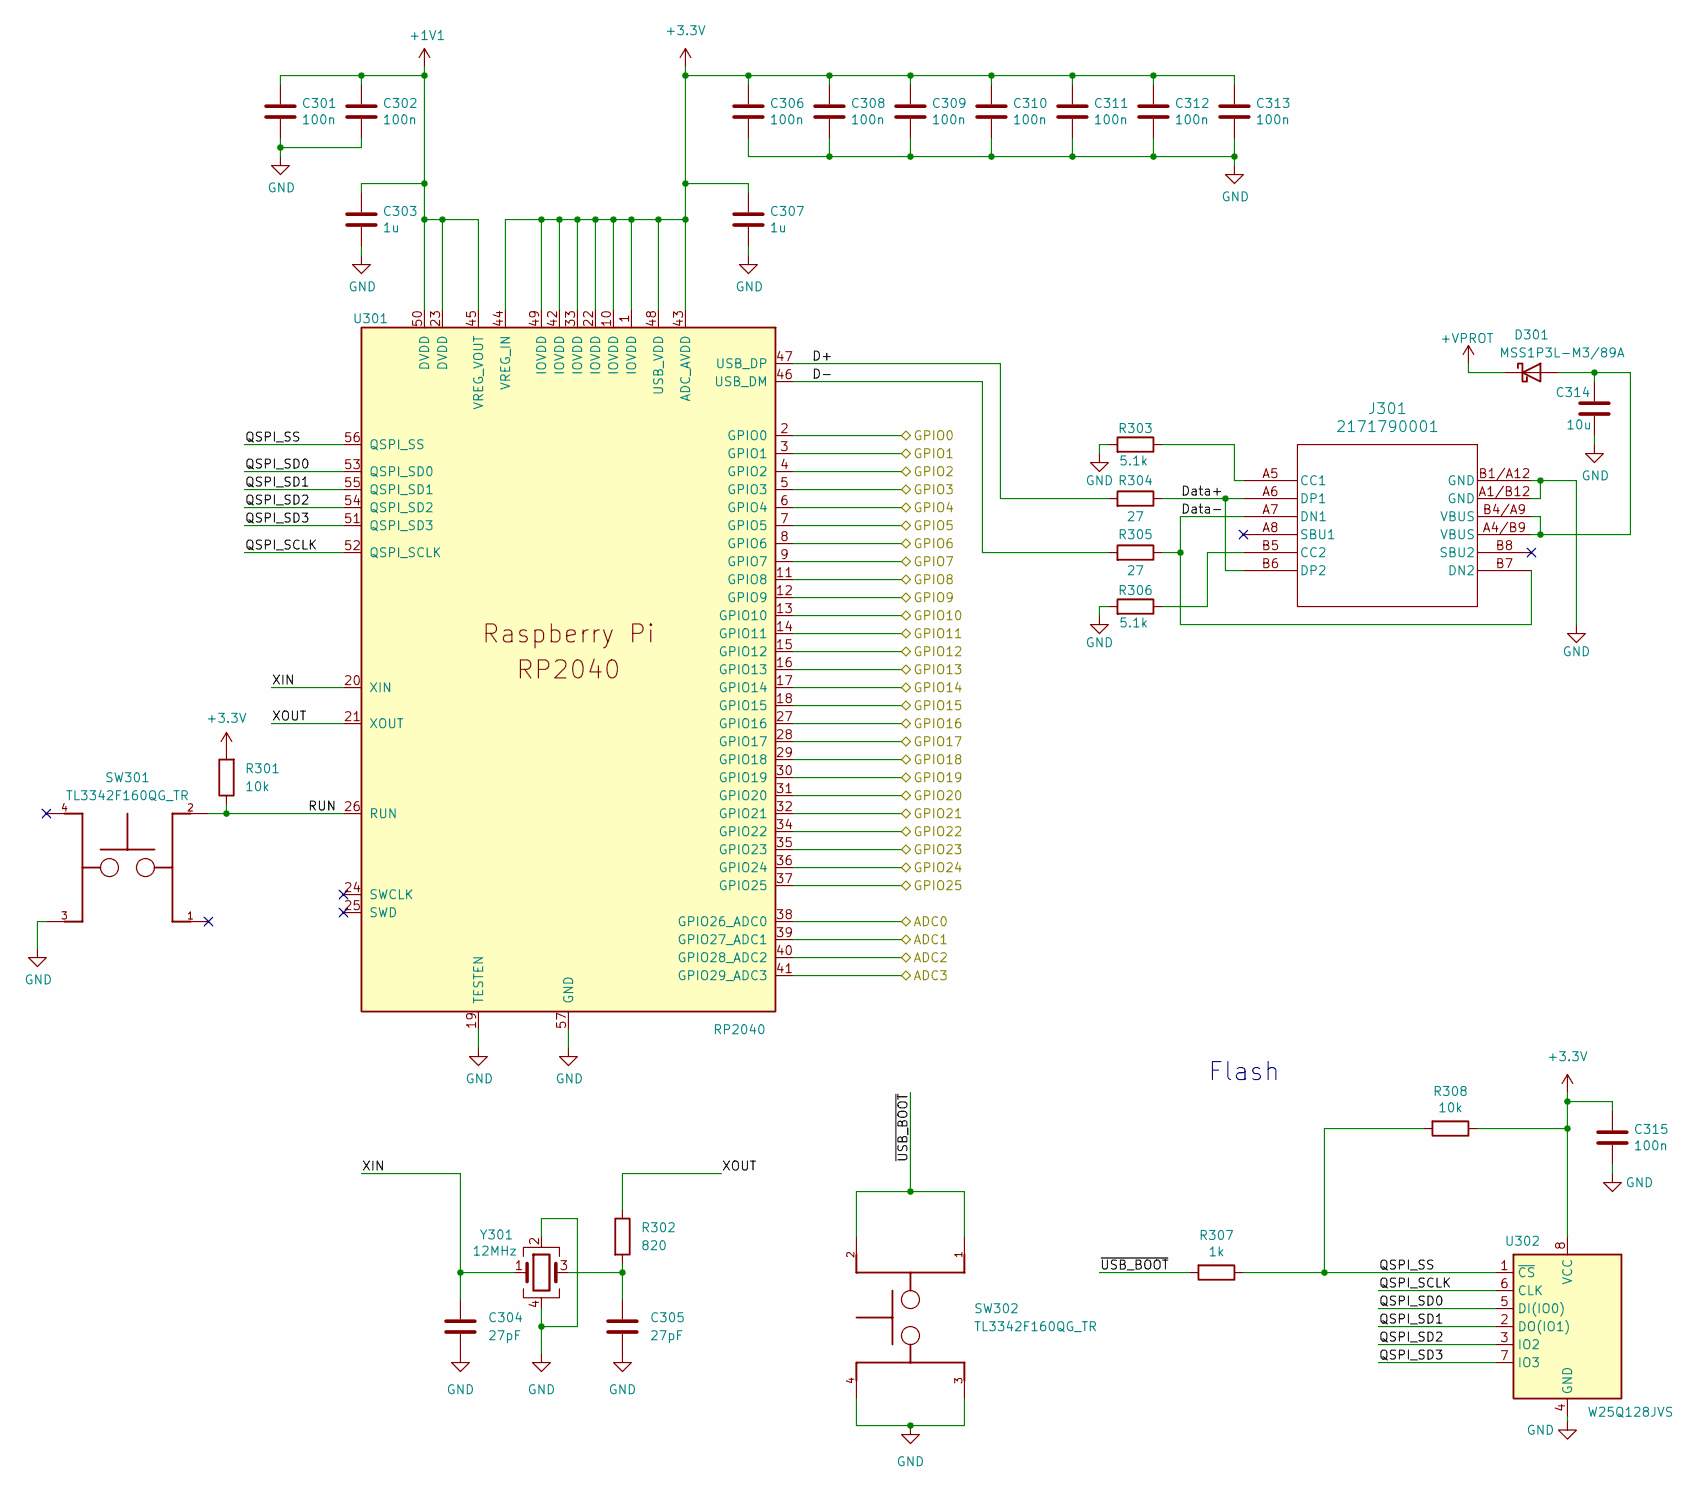
[picture p19: schematic rp2040.kicad_sch]

Parts:
C301, C302, C306, C308, C309, C310, C311, C312, C313, C315: 100n; C_0603_1608Metric_Pad1.08x0.95mm_HandSolder
C303, C307: 1u; C_0603_1608Metric_Pad1.08x0.95mm_HandSolder
C304, C305: 27pF; C_0603_1608Metric_Pad1.08x0.95mm_HandSolder
C314: 10u; C_0603_1608Metric_Pad1.08x0.95mm_HandSolder
D301: MSS1P3L-M3/89A; Vishay_SMPA
J301: 2171790001; 2171790001_MOL
R301: 10k; C_0603_1608Metric_Pad1.08x0.95mm_HandSolder
R302: 820; R_0603_1608Metric_Pad0.98x0.95mm_HandSolder
R303, R306: 5.1k; R_0603_1608Metric_Pad0.98x0.95mm_HandSolder
R304, R305: 27; R_0603_1608Metric_Pad0.98x0.95mm_HandSolder
R307: 1k; R_0603_1608Metric_Pad0.98x0.95mm_HandSolder
R308: 10k; R_0603_1608Metric_Pad0.98x0.95mm_HandSolder
SW301, SW302: TL3342F160QG_TR; SW_TL3342F160QG_TR
U301: RP2040; QFN-56-1EP_7x7mm_P0.4mm_EP3.2x3.2mm
U302: W25Q128JVS; SOIC-8_5.3x5.3mm_P1.27mm
Y301: 12MHz; Crystal_SMD_Abracon_ABM8G-4Pin_3.2x2.5mm

Connections:
+1V1: C301.1, C302.1, C303.1, U301.23 (DVDD), U301.45 (VREG_VOUT), U301.50 (DVDD)
+3.3V: C306.1, C307.1, C308.1, C309.1, C310.1, C311.1, C312.1, C313.1, C315.1, R301.2, R308.1, U301.1 (IOVDD), U301.10 (IOVDD), U301.22 (IOVDD), U301.33 (IOVDD), U301.42 (IOVDD), U301.43 (ADC_AVDD), U301.44 (VREG_IN), U301.48 (USB_VDD), U301.49 (IOVDD), U302.8 (VCC); also elsewhere on the board
+VPROT: D301.1 (K); also elsewhere on the board
/AHS: U301.37 (GPIO25); also elsewhere on the board
/ALS: U301.36 (GPIO24); also elsewhere on the board
/BEMF: U301.8 (GPIO6); also elsewhere on the board
/BHS: U301.35 (GPIO23); also elsewhere on the board
/BLS: U301.34 (GPIO22); also elsewhere on the board
/CE: U301.9 (GPIO7); also elsewhere on the board
/CHS: U301.32 (GPIO21); also elsewhere on the board
/CLS: U301.31 (GPIO20); also elsewhere on the board
/CSN: U301.11 (GPIO8); also elsewhere on the board
/ICM42688 - Gyro/AP_CS: U301.12 (GPIO9); also elsewhere on the board
/ICM42688 - Gyro/AP_SCL: U301.14 (GPIO11); also elsewhere on the board
/ICM42688 - Gyro/AP_SDA: U301.13 (GPIO10); also elsewhere on the board
/ICM42688 - Gyro/AP_SDO: U301.16 (GPIO13); also elsewhere on the board
/ICM42688 - Gyro/INT1: U301.15 (GPIO12); also elsewhere on the board
/MISO: U301.27 (GPIO16); also elsewhere on the board
/MOSI: U301.30 (GPIO19); also elsewhere on the board
/OUT3: U301.17 (GPIO14); also elsewhere on the board
/OUT4: U301.18 (GPIO15); also elsewhere on the board
/Power supply unit/Battery_voltage_level: U301.39 (GPIO27_ADC1); also elsewhere on the board
/RP2040/ADC0: U301.38 (GPIO26_ADC0); also elsewhere on the board
/RP2040/ADC2: U301.40 (GPIO28_ADC2)
/RP2040/ADC3: U301.41 (GPIO29_ADC3)
/RP2040/D+: R304.2, U301.47 (USB_DP)
/RP2040/D-: R305.2, U301.46 (USB_DM)
/RP2040/Data+: J301.A6 (DP1), J301.B6 (DP2), R304.1
/RP2040/Data-: J301.A7 (DN1), J301.B7 (DN2), R305.1
/RP2040/GPIO0: U301.2 (GPIO0); also elsewhere on the board
/RP2040/GPIO1: U301.3 (GPIO1); also elsewhere on the board
/RP2040/GPIO2: U301.4 (GPIO2); also elsewhere on the board
/RP2040/GPIO3: U301.5 (GPIO3); also elsewhere on the board
/RP2040/GPIO4: U301.6 (GPIO4); also elsewhere on the board
/RP2040/GPIO5: U301.7 (GPIO5); also elsewhere on the board
/RP2040/QSPI_SCLK: U301.52 (QSPI_SCLK), U302.6 (CLK)
/RP2040/QSPI_SD0: U301.53 (QSPI_SD0), U302.5 (DI(IO0))
/RP2040/QSPI_SD1: U301.55 (QSPI_SD1), U302.2 (DO(IO1))
/RP2040/QSPI_SD2: U301.54 (QSPI_SD2), U302.3 (IO2)
/RP2040/QSPI_SD3: U301.51 (QSPI_SD3), U302.7 (IO3)
/RP2040/QSPI_SS: R307.1, R308.2, U301.56 (QSPI_SS), U302.1 (~CS)
/RP2040/RUN: R301.1, SW301.2, U301.26 (RUN)
/RP2040/XIN: C304.1, U301.20 (XIN), Y301.1
/RP2040/XOUT: R302.1, U301.21 (XOUT)
/RP2040/~USB_BOOT: R307.2, SW302.1, SW302.2
/SCK: U301.29 (GPIO18); also elsewhere on the board
/Servo_In: U301.28 (GPIO17); also elsewhere on the board
GND: C301.2, C302.2, C303.2, C304.2, C305.2, C306.2, C307.2, C308.2, C309.2, C310.2, C311.2, C312.2, C313.2, C314.2, C315.2, J301.A1/B12 (GND), J301.B1/A12 (GND), R303.2, R306.2, SW301.3, SW302.3, SW302.4, U301.19 (TESTEN), U301.57 (GND), U302.4 (GND), Y301.2, Y301.4; also elsewhere on the board
unnamed: C305.1, R302.2, Y301.3
unnamed: C314.1, D301.2 (A), J301.A4/B9 (VBUS), J301.B4/A9 (VBUS)
unnamed: J301.A5 (CC1), R303.1
unnamed: J301.B5 (CC2), R306.1

Notes on the sheet:
Flash

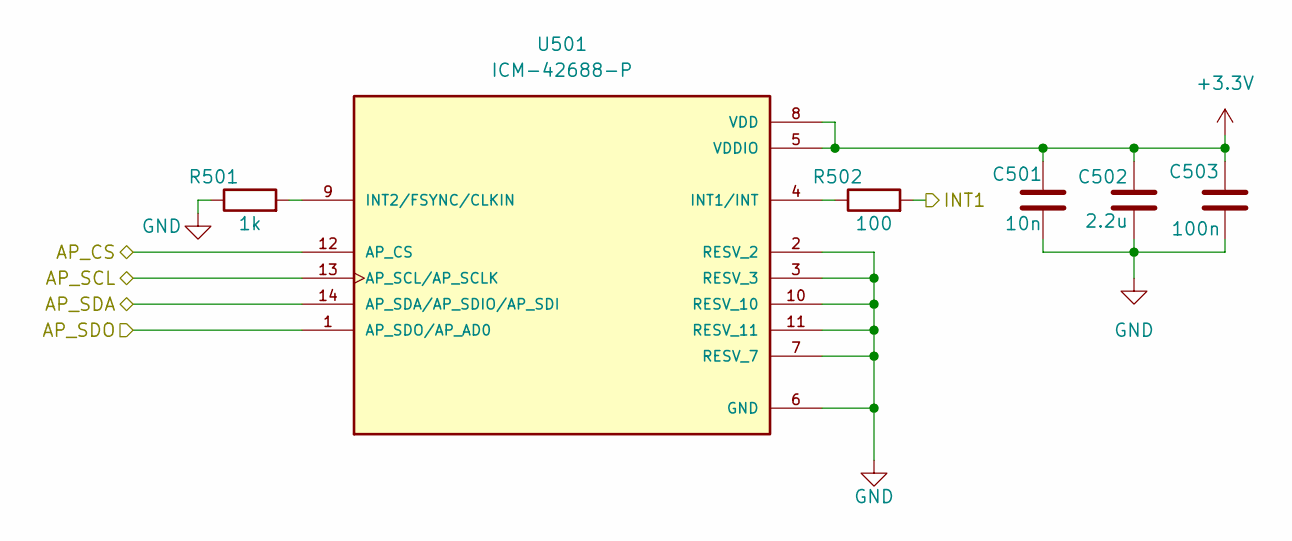
[picture p20: schematic ICM42688.kicad_sch]

Parts:
C501: 10n; C_0805_2012Metric_Pad1.18x1.45mm_HandSolder
C502: 2.2u; C_0805_2012Metric_Pad1.18x1.45mm_HandSolder
C503: 100n; C_0805_2012Metric_Pad1.18x1.45mm_HandSolder
R501: 1k; R_0603_1608Metric_Pad0.98x0.95mm_HandSolder
R502: 100; R_0603_1608Metric_Pad0.98x0.95mm_HandSolder
U501: ICM-42688-P; PQFN50P300X250X97-14N; PARTREV 1.2

Connections:
+3.3V: C501.1, C502.2, C503.2, U501.5 (VDDIO), U501.8 (VDD); also elsewhere on the board
/ICM42688 - Gyro/AP_CS: U501.12 (AP_CS); also elsewhere on the board
/ICM42688 - Gyro/AP_SCL: U501.13 (AP_SCL/AP_SCLK); also elsewhere on the board
/ICM42688 - Gyro/AP_SDA: U501.14 (AP_SDA/AP_SDIO/AP_SDI); also elsewhere on the board
/ICM42688 - Gyro/AP_SDO: U501.1 (AP_SDO/AP_AD0); also elsewhere on the board
/ICM42688 - Gyro/INT1: R502.2; also elsewhere on the board
GND: C501.2, C502.1, C503.1, R501.1, U501.2 (RESV_2), U501.3 (RESV_3), U501.6 (GND), U501.7 (RESV_7), U501.10 (RESV_10), U501.11 (RESV_11); also elsewhere on the board
unnamed: R502.1, U501.4 (INT1/INT)
unnamed: R501.2, U501.9 (INT2/FSYNC/CLKIN)

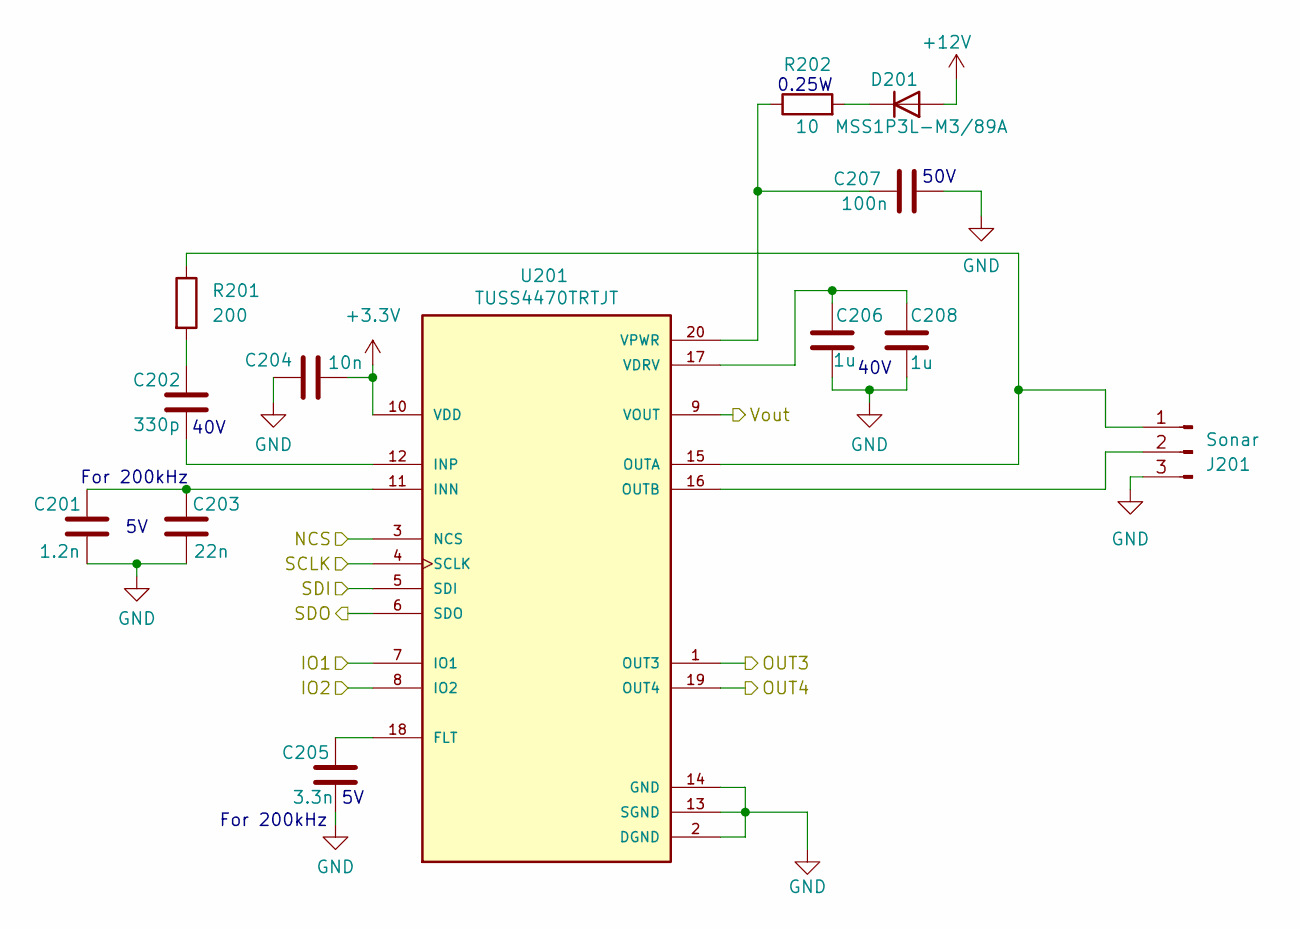
[picture p21: schematic sonar.kicad_sch]

Parts:
C201: 1.2n; C_0603_1608Metric_Pad1.08x0.95mm_HandSolder
C202: 330p; C_0805_2012Metric_Pad1.18x1.45mm_HandSolder
C203: 22n; C_0603_1608Metric_Pad1.08x0.95mm_HandSolder
C204: 10n; C_0805_2012Metric_Pad1.18x1.45mm_HandSolder
C205: 3.3n; C_0805_2012Metric_Pad1.18x1.45mm_HandSolder
C206, C208: 1u; C_0603_1608Metric_Pad1.08x0.95mm_HandSolder
C207: 100n; C_0805_2012Metric_Pad1.18x1.45mm_HandSolder
D201: MSS1P3L-M3/89A; Vishay_SMPA
J201: Sonar; JST_PH_B3B-PH-K_1x03_P2.00mm_Vertical
R201: 200; R_0603_1608Metric_Pad0.98x0.95mm_HandSolder
R202: 10; C_0805_2012Metric_Pad1.18x1.45mm_HandSolder
U201: TUSS4470TRTJT; QFN50P400X400X80-21N; PARTREV December 2019

Connections:
+3.3V: C204.1, U201.10 (VDD); also elsewhere on the board
+12V: D201.2 (A); also elsewhere on the board
/OUT3: U201.1 (OUT3); also elsewhere on the board
/OUT4: U201.19 (OUT4); also elsewhere on the board
/RP2040/ADC0: U201.9 (VOUT); also elsewhere on the board
/RP2040/GPIO0: U201.4 (SCLK); also elsewhere on the board
/RP2040/GPIO1: U201.3 (NCS); also elsewhere on the board
/RP2040/GPIO2: U201.6 (SDO); also elsewhere on the board
/RP2040/GPIO3: U201.5 (SDI); also elsewhere on the board
/RP2040/GPIO4: U201.7 (IO1); also elsewhere on the board
/RP2040/GPIO5: U201.8 (IO2); also elsewhere on the board
GND: C201.1, C203.1, C204.2, C205.1, C206.1, C207.2, C208.1, J201.3, U201.2 (DGND), U201.13 (SGND), U201.14 (GND); also elsewhere on the board
unnamed: C202.2, R201.2
unnamed: D201.1 (K), R202.2
unnamed: J201.1, R201.1, U201.15 (OUTA)
unnamed: J201.2, U201.16 (OUTB)
unnamed: C205.2, U201.18 (FLT)
unnamed: C201.2, C203.2, U201.11 (INN)
unnamed: C202.1, U201.12 (INP)
unnamed: C206.2, C208.2, U201.17 (VDRV)
unnamed: C207.1, R202.1, U201.20 (VPWR)

Notes on the sheet:
40V
50V
For 200kHz
0.25W

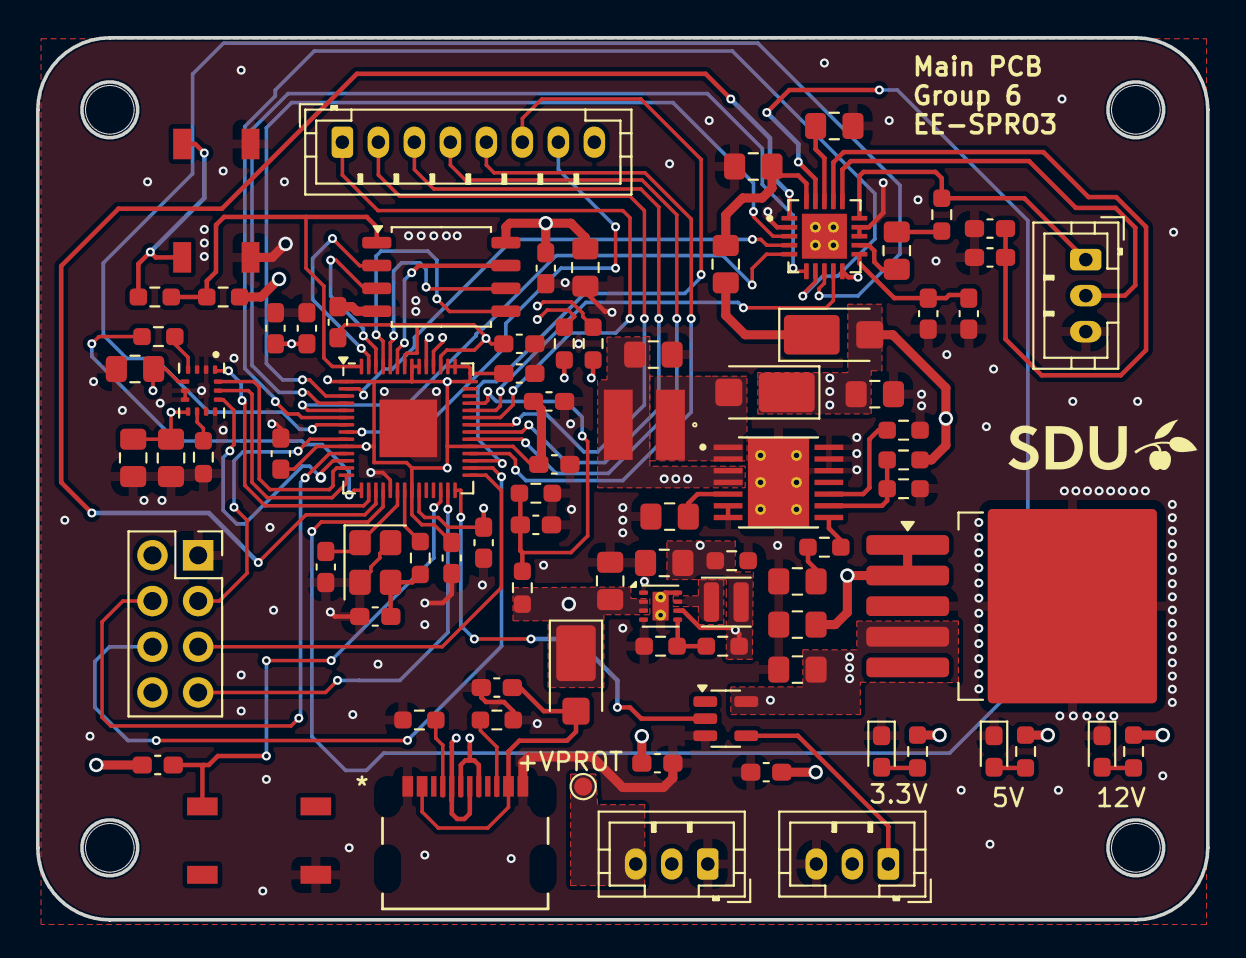
[picture p22: board Main_PCB.kicad_pcb from above]

Board: 4 copper layers, 65.0 x 49.0 mm, 90 parts (0 on the bottom side), 75 nets.
