milanovviktorio/harbor-measuring-device-SPRO3/Hardware/ESC and BMS/ESC_BMS/SPROJ3EE_ESC_BMS.kicad_pcb

## KiCad design Hardware/ESC and BMS/ESC_BMS/SPROJ3EE_ESC_BMS.kicad_pcb (2025-11-18)

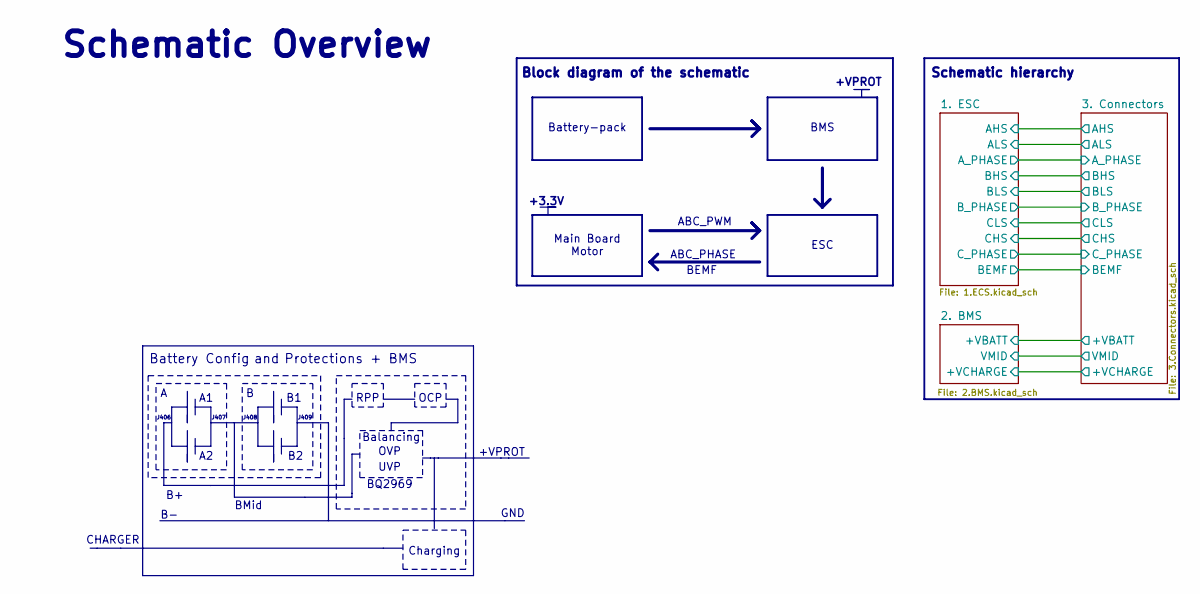
[picture p23: schematic SPROJ3EE_ESC_BMS.kicad_sch, SPROJ3EE ESC & BMS]

Notes on the sheet:
UVP
Schematic Overview
J409
J406
Balancing
J407
Protections + BMS
Battery Config
OCP
CHARGER
+VPROT
+3.3V
Charging
Schematic hierarchy
Battery-pack
and
Main Board Motor
J408
ABC_PWM
RPP
Block diagram of the schematic
GND
ABC_PHASE
BQ2969
BEMF
ESC
OVP
BMid
BMS

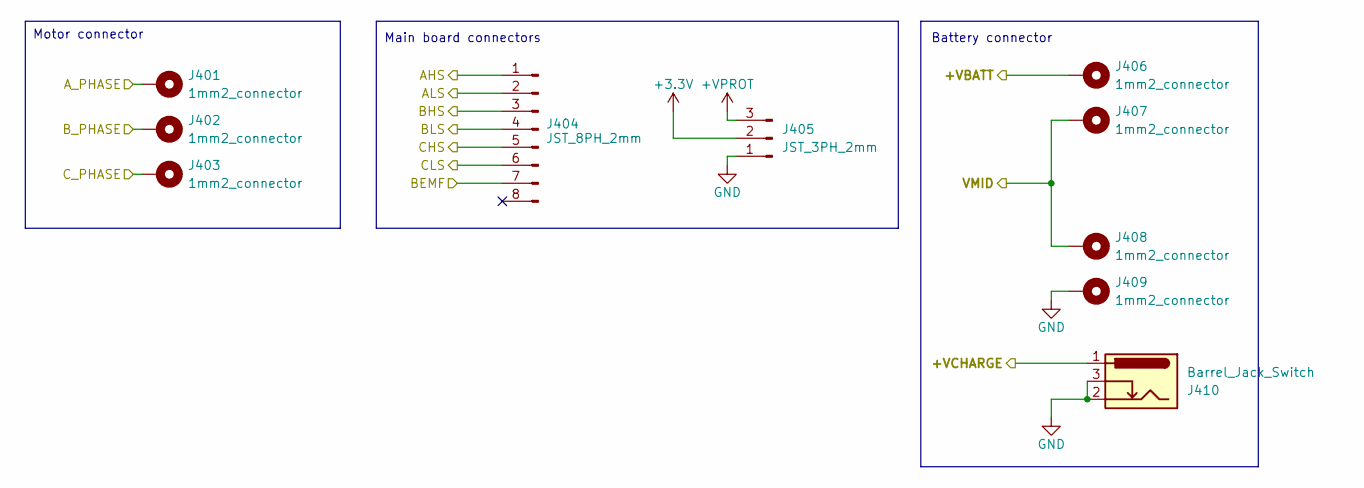
[picture p24: schematic 3.Connectors.kicad_sch, SPROJ3EE ESC & BMS]

Parts:
J401, J402, J403, J406, J407, J408, J409: 1mm2_connector; SolderWire-1sqmm_1x01_D1.4mm_OD2.7mm
J404: JST_8PH_2mm; JST_PH_B8B-PH-K_1x08_P2.00mm_Vertical
J405: JST_3PH_2mm; JST_PH_B3B-PH-K_1x03_P2.00mm_Vertical
J410: Barrel_Jack_Switch; BarrelJack_Horizontal

Connections:
+3.3V: J405.2; also elsewhere on the board
+VPROT: J405.3; also elsewhere on the board
/1. ESC/AHS: J404.1; also elsewhere on the board
/1. ESC/ALS: J404.2; also elsewhere on the board
/1. ESC/BEMF: J404.7; also elsewhere on the board
/1. ESC/BHS: J404.3; also elsewhere on the board
/1. ESC/BLS: J404.4; also elsewhere on the board
/1. ESC/CHS: J404.5; also elsewhere on the board
/1. ESC/CLS: J404.6; also elsewhere on the board
/2. BMS/+VBATT: J406.1; also elsewhere on the board
/2. BMS/+VCHARGE: J410.1; also elsewhere on the board
/2. BMS/VMID: J407.1, J408.1; also elsewhere on the board
A_PHASE: J401.1; also elsewhere on the board
B_PHASE: J402.1; also elsewhere on the board
C_PHASE: J403.1; also elsewhere on the board
GND: J405.1, J409.1, J410.2, J410.3; also elsewhere on the board

Notes on the sheet:
Main board connectors
Motor connector
Battery connector

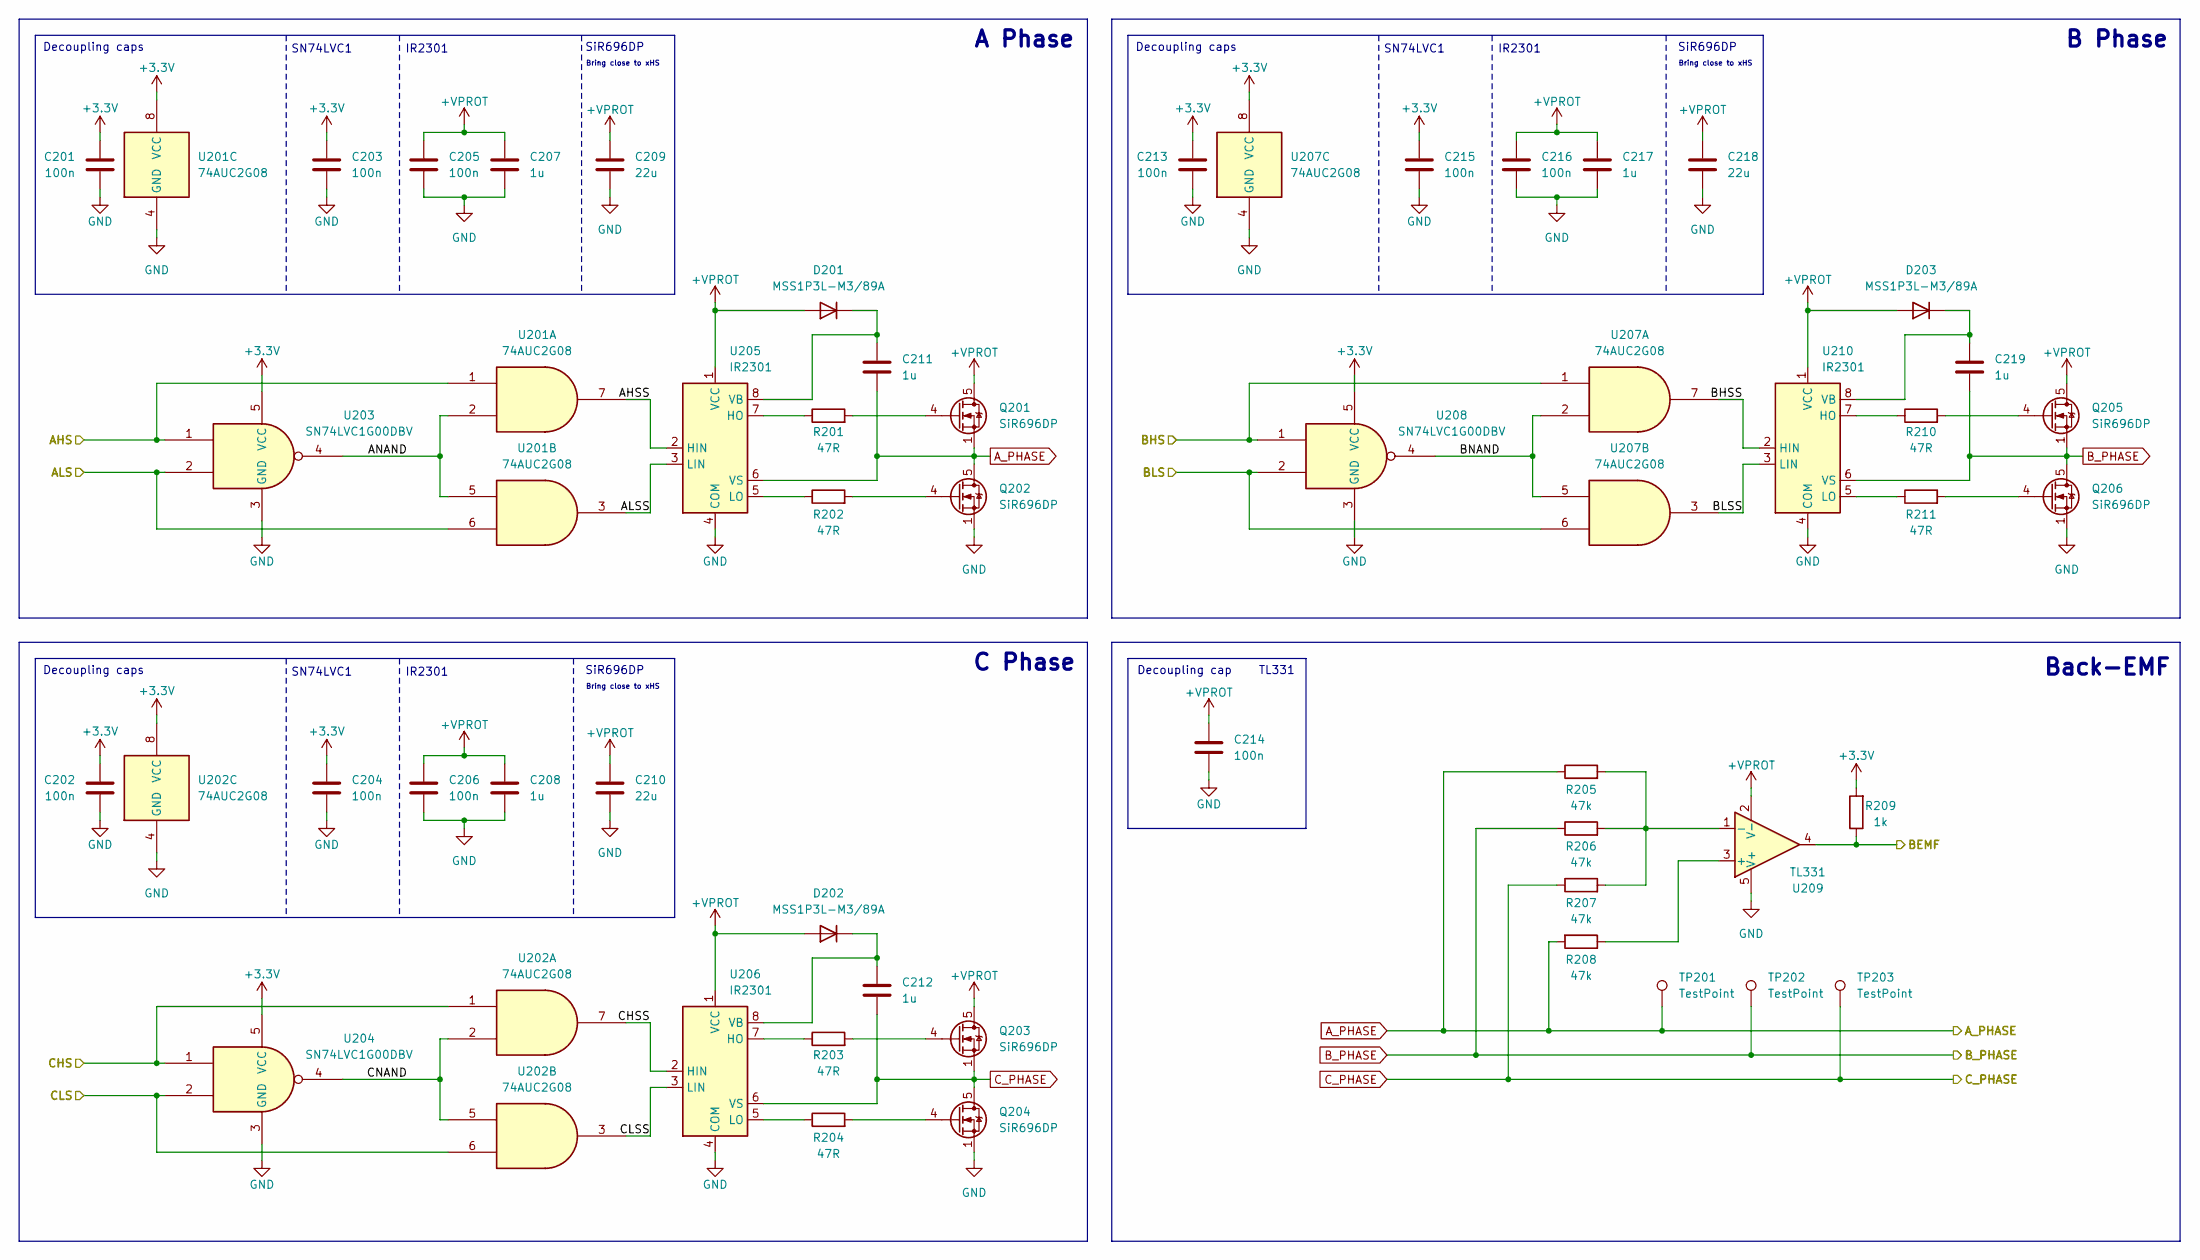
[picture p25: schematic 1.ECS.kicad_sch, SPROJ3EE ESC & BMS]

Parts:
C201, C202, C203, C204, C205, C206, C213, C214, C215, C216: 100n; C_0603_1608Metric
C207, C208, C211, C212, C217, C219: 1u; C_0603_1608Metric
C209, C210, C218: 22u; C_0805_2012Metric_Pad1.18x1.45mm_HandSolder
D201, D202, D203: MSS1P3L-M3/89A; Vishay_SMPA
Q201, Q202, Q203, Q204, Q205, Q206: SiR696DP; PowerPAK_SO-8_Single
R201, R202, R203, R204, R210, R211: 47R; R_0603_1608Metric
R205, R206, R207, R208: 47k; R_0603_1608Metric
R209: 1k; R_0603_1608Metric
TP201, TP202, TP203: TestPoint; TestPoint_Pad_D1.0mm
U201, U202, U207: 74AUC2G08; SSOP-8_2.95x2.8mm_P0.65mm
U203, U204, U208: SN74LVC1G00DBV; SOT-23-5
U205, U206, U210: IR2301; SOIC-8_3.9x4.9mm_P1.27mm
U209: TL331; SOT-23-5

Connections:
+3.3V: C201.1, C202.1, C203.1, C204.1, C213.1, C215.1, R209.2, U201.8 (VCC), U202.8 (VCC), U203.5 (VCC), U204.5 (VCC), U207.8 (VCC), U208.5 (VCC); also elsewhere on the board
+VPROT: C205.1, C206.1, C207.1, C208.1, C209.1, C210.1, C214.1, C216.1, C217.1, C218.1, D201.2 (A), D202.2 (A), D203.2 (A), Q201.5 (D), Q203.5 (D), Q205.5 (D), U205.1 (VCC), U206.1 (VCC), U209.2 (V-), U210.1 (VCC); also elsewhere on the board
/1. ESC/AHS: U201.1, U203.1; also elsewhere on the board
/1. ESC/AHSS: U201.7, U205.2 (HIN)
/1. ESC/ALS: U201.6, U203.2; also elsewhere on the board
/1. ESC/ALSS: U201.3, U205.3 (LIN)
/1. ESC/ANAND: U201.2, U201.5, U203.4
/1. ESC/BEMF: R209.1, U209.4; also elsewhere on the board
/1. ESC/BHS: U207.1, U208.1; also elsewhere on the board
/1. ESC/BHSS: U207.7, U210.2 (HIN)
/1. ESC/BLS: U207.6, U208.2; also elsewhere on the board
/1. ESC/BLSS: U207.3, U210.3 (LIN)
/1. ESC/BNAND: U207.2, U207.5, U208.4
/1. ESC/CHS: U202.1, U204.1; also elsewhere on the board
/1. ESC/CHSS: U202.7, U206.2 (HIN)
/1. ESC/CLS: U202.6, U204.2; also elsewhere on the board
/1. ESC/CLSS: U202.3, U206.3 (LIN)
/1. ESC/CNAND: U202.2, U202.5, U204.4
A_PHASE: C211.2, Q201.1 (S), Q201.2 (S), Q201.3 (S), Q202.5 (D), R205.1, R208.2, TP201.1, U205.6 (VS); also elsewhere on the board
B_PHASE: C219.2, Q205.1 (S), Q205.2 (S), Q205.3 (S), Q206.5 (D), R206.1, TP202.1, U210.6 (VS); also elsewhere on the board
C_PHASE: C212.2, Q203.1 (S), Q203.2 (S), Q203.3 (S), Q204.5 (D), R207.1, TP203.1, U206.6 (VS); also elsewhere on the board
GND: C201.2, C202.2, C203.2, C204.2, C205.2, C206.2, C207.2, C208.2, C209.2, C210.2, C213.2, C214.2, C215.2, C216.2, C217.2, C218.2, Q202.1 (S), Q202.2 (S), Q202.3 (S), Q204.1 (S), Q204.2 (S), Q204.3 (S), Q206.1 (S), Q206.2 (S), Q206.3 (S), U201.4 (GND), U202.4 (GND), U203.3 (GND), U204.3 (GND), U205.4 (COM), U206.4 (COM), U207.4 (GND), U208.3 (GND), U209.5 (V+), U210.4 (COM); also elsewhere on the board
unnamed: C211.1, D201.1 (K), U205.8 (VB)
unnamed: C212.1, D202.1 (K), U206.8 (VB)
unnamed: C219.1, D203.1 (K), U210.8 (VB)
unnamed: Q201.4 (G), R201.2
unnamed: Q202.4 (G), R202.2
unnamed: Q203.4 (G), R203.2
unnamed: Q204.4 (G), R204.2
unnamed: Q205.4 (G), R210.2
unnamed: Q206.4 (G), R211.2
unnamed: R201.1, U205.7 (HO)
unnamed: R202.1, U205.5 (LO)
unnamed: R203.1, U206.7 (HO)
unnamed: R204.1, U206.5 (LO)
unnamed: R208.1, U209.3 (+)
unnamed: R205.2, R206.2, R207.2, U209.1 (-)
unnamed: R210.1, U210.7 (HO)
unnamed: R211.1, U210.5 (LO)

Notes on the sheet:
Bring close to xHS
C Phase
SiR696DP
SN74LVC1
Decoupling caps
TL331
IR2301
B Phase
Back-EMF
A Phase
Decoupling cap

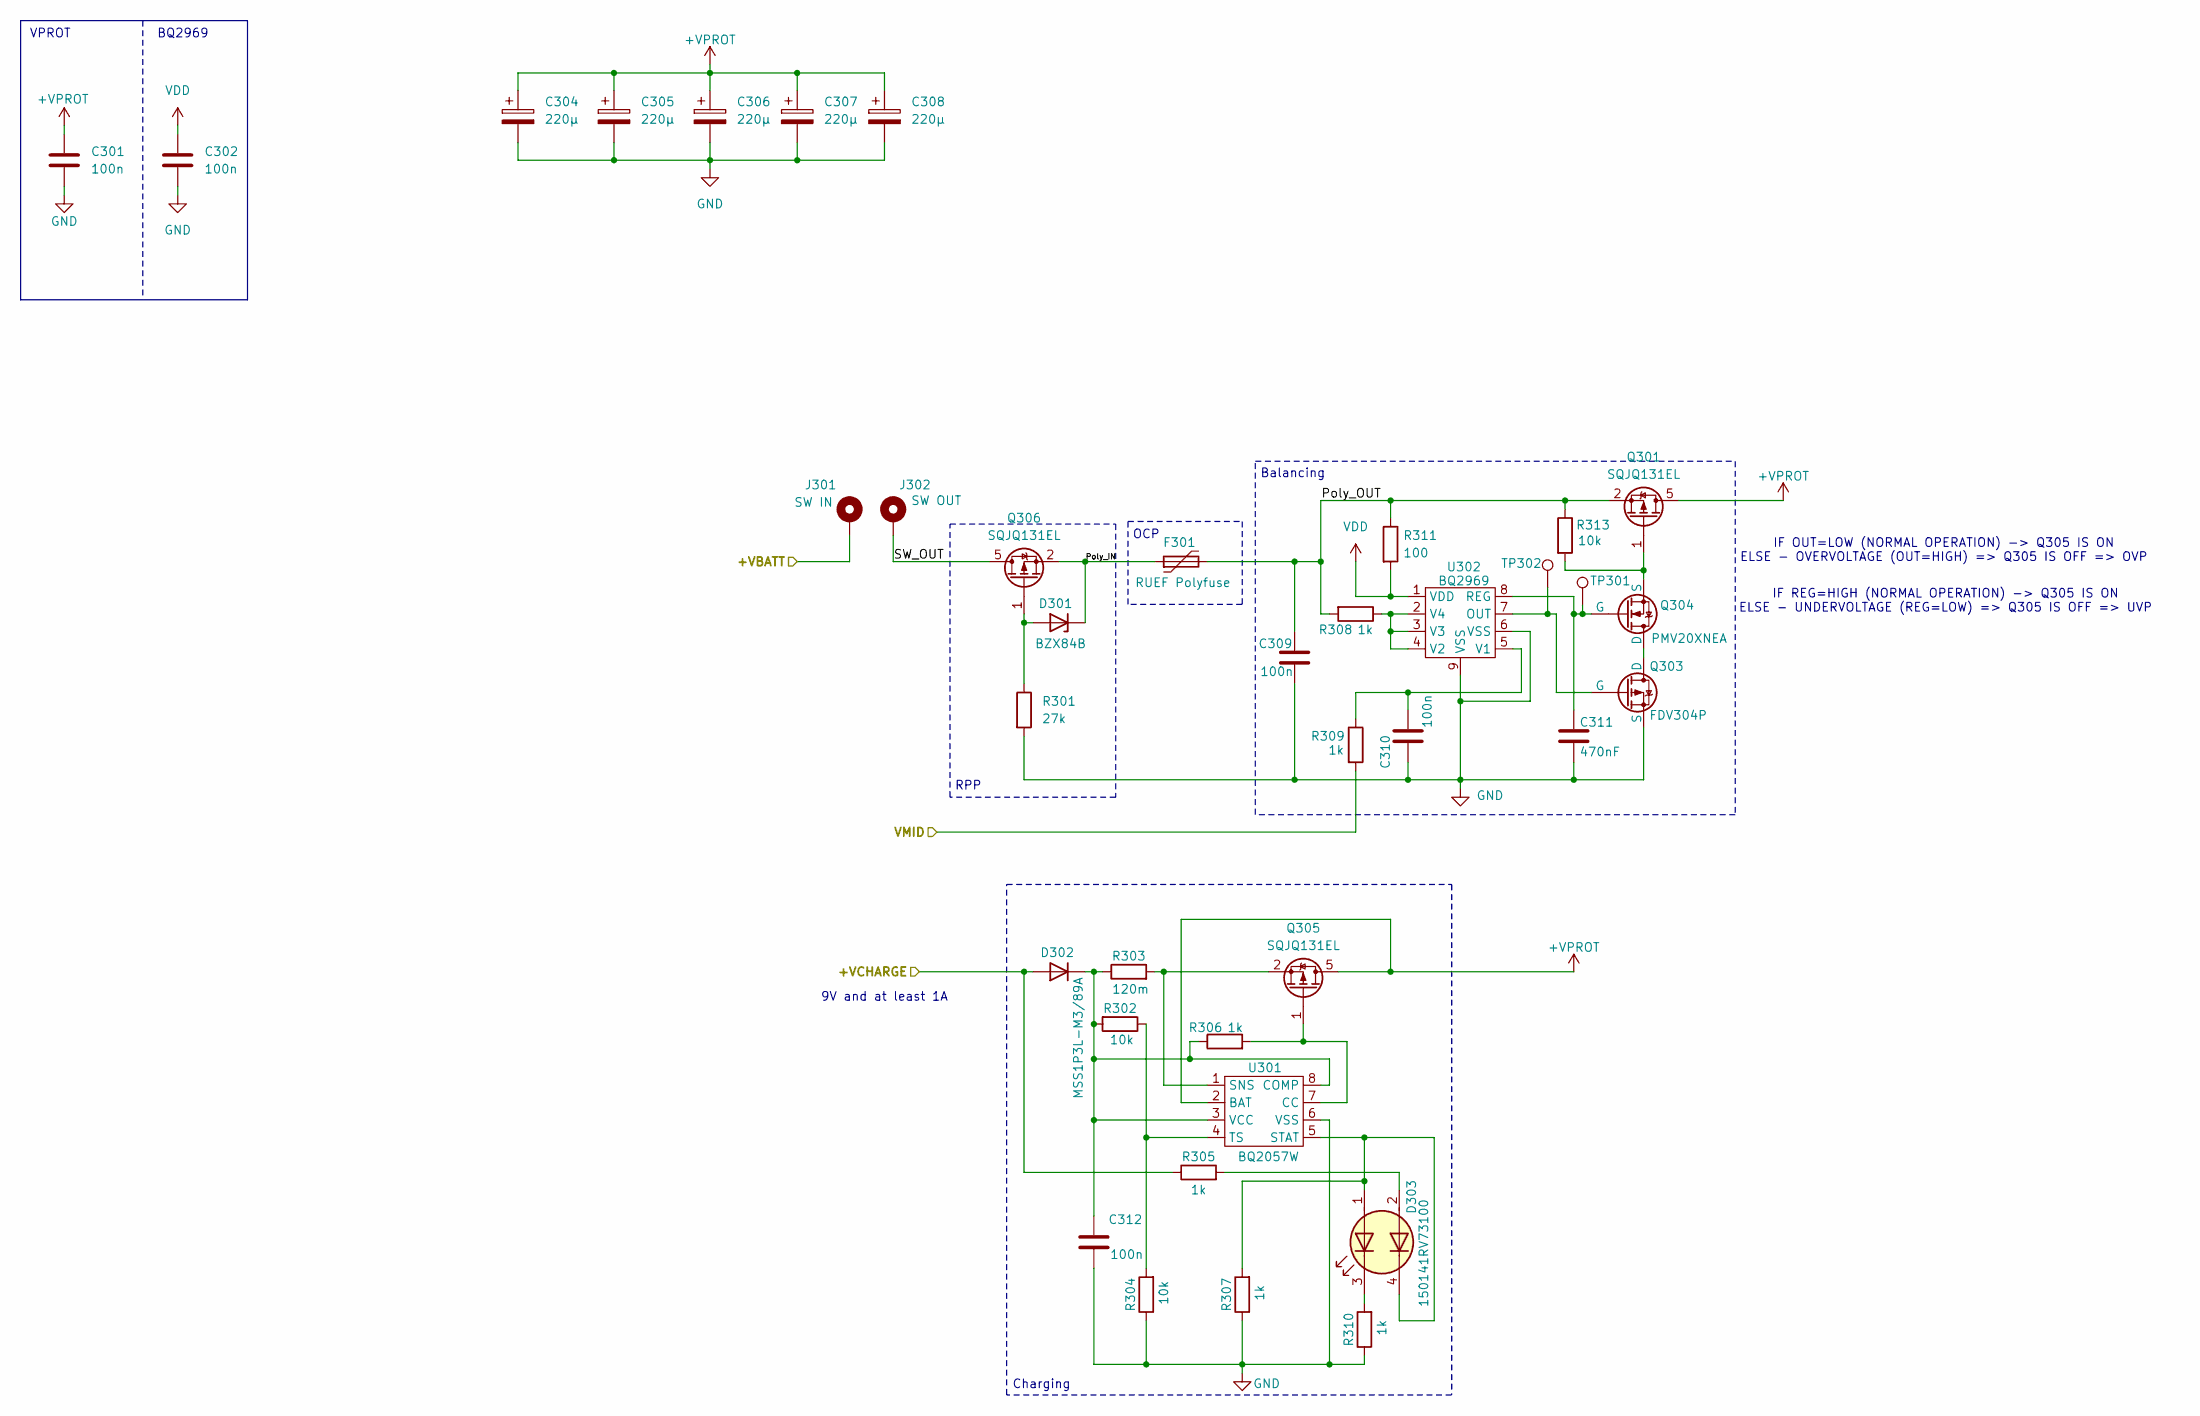
[picture p26: schematic 2.BMS.kicad_sch, SPROJ3EE ESC & BMS]

Parts:
C301, C309, C310: 100n; C_0603_1608Metric
C302: 100n; C_0603_1608Metric_Pad1.08x0.95mm_HandSolder
C304, C305, C306, C307, C308: 220µ; CP_Elec_6.3x5.9
C311: 470nF; C_0603_1608Metric_Pad1.08x0.95mm_HandSolder
C312: 100n; C_0805_2012Metric_Pad1.18x1.45mm_HandSolder
D301: BZX84B; SOT-23
D302: MSS1P3L-M3/89A; Vishay_SMPA
D303: 150141RV73100; LED_RGB_Wuerth-PLCC4_3.2x2.8mm_150141M173100
F301: RUEF Polyfuse; R_Axial_DIN0207_L6.3mm_D2.5mm_P10.16mm_Horizontal
J301: SW IN; SolderWire-1sqmm_1x01_D1.4mm_OD2.7mm
J302: SW OUT; SolderWire-1sqmm_1x01_D1.4mm_OD2.7mm
Q301, Q305, Q306: SQJQ131EL; PowerPAK_SO-8L_Single
Q303: FDV304P; SOT-23
Q304: PMV20XNEA; SOT-23
R301: 27k; R_0603_1608Metric
R302, R304, R313: 10k; R_0603_1608Metric
R303: 120m; R_0805_2012Metric_Pad1.20x1.40mm_HandSolder
R305, R306, R307, R308, R309, R310: 1k; R_0603_1608Metric
R311: 100; R_0603_1608Metric
TP301, TP302: TestPoint; TestPoint_Pad_D1.0mm
U301: BQ2057W; SOIC-8_5.3x5.3mm_P1.27mm
U302: BQ2969; WSON-8-1EP_3x3mm_P0.5mm_EP1.2x2mm_ThermalVias

Connections:
+VPROT: C301.1, C304.1, C305.1, C306.1, C307.1, C308.1, Q301.5 (D), Q305.5 (D), U301.2 (BAT); also elsewhere on the board
/2. BMS/+VBATT: J301.1; also elsewhere on the board
/2. BMS/+VCHARGE: D302.2 (A), R305.1; also elsewhere on the board
/2. BMS/Poly_IN: D301.1 (K), F301.1, Q306.2 (S), Q306.3 (S), Q306.4 (S)
/2. BMS/Poly_OUT: C309.1, F301.2, Q301.2 (S), Q301.3 (S), Q301.4 (S), R308.2, R311.1, R313.1
/2. BMS/SW_OUT: J302.1, Q306.5 (D)
/2. BMS/VMID: R309.2; also elsewhere on the board
GND: C301.2, C302.2, C304.2, C305.2, C306.2, C307.2, C308.2, C309.2, C310.1, C311.2, C312.2, Q303.3 (S), R301.2, R304.1, R307.1, R310.1, U301.6 (VSS), U302.6 (VSS), U302.9 (VSS); also elsewhere on the board
unnamed: D301.2 (A), Q306.1 (G), R301.1
unnamed: C312.1, D302.1 (K), R302.2, R303.1, R306.1, U301.3 (VCC), U301.8 (COMP)
unnamed: D303.1 (A1), D303.4 (K2), R307.2, U301.5 (STAT)
unnamed: D303.2 (A2), R305.2
unnamed: D303.3 (K1), R310.2
unnamed: Q301.1 (G), Q304.3 (S), R313.2
unnamed: Q303.1 (D), Q304.1 (D)
unnamed: Q303.2 (G), TP302.1, U302.7 (OUT)
unnamed: C311.1, Q304.2 (G), TP301.1, U302.8 (REG)
unnamed: Q305.1 (G), R306.2, U301.7 (CC)
unnamed: Q305.2 (S), Q305.3 (S), Q305.4 (S), R303.2, U301.1 (SNS)
unnamed: R302.1, R304.2, U301.4 (TS)
unnamed: C310.2, R309.1, U302.5 (V1)
unnamed: R308.1, U302.2 (V4), U302.3 (V3), U302.4 (V2)
VDD: C302.1, R311.2, U302.1 (VDD)

Notes on the sheet:
9V and at least 1A
IF OUT=LOW (NORMAL OPERATION) -> Q305 IS ON ELSE - OVERVOLTAGE (OUT=HIGH) => Q305 IS OFF => OVP
IF REG=HIGH (NORMAL OPERATION) -> Q305 IS ON ELSE - UNDERVOLTAGE (REG=LOW) => Q305 IS OFF => UVP
Charging
VPROT
OCP
BQ2969
Balancing
RPP

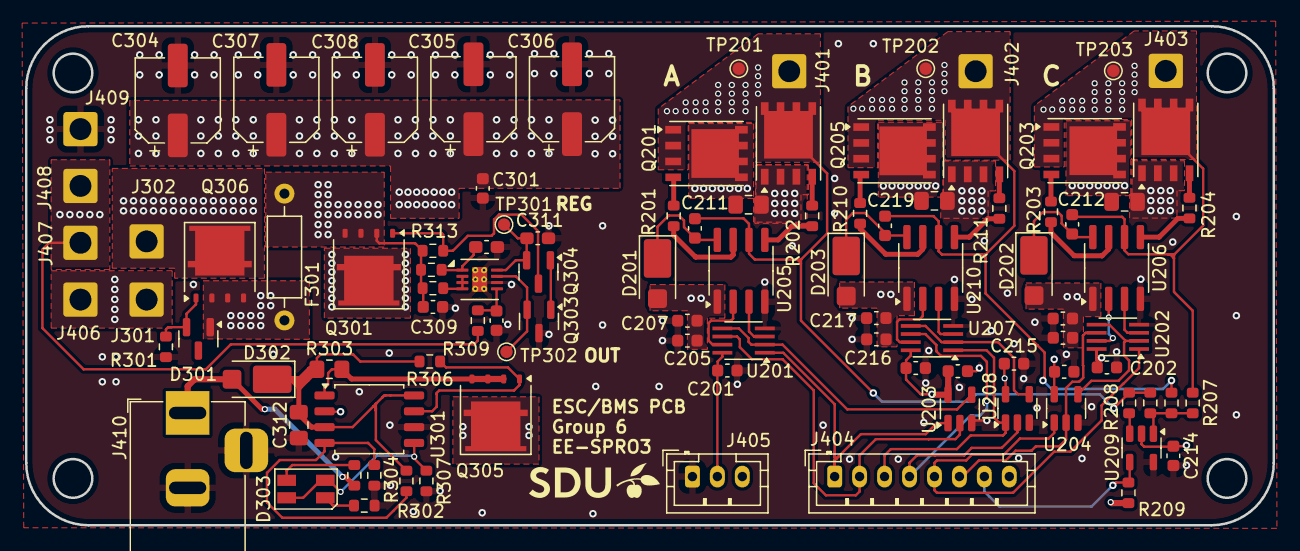
[picture p27: board SPROJ3EE_ESC_BMS.kicad_pcb from above]

Board: 4 copper layers, 100.0 x 40.0 mm, 100 parts (0 on the bottom side), 60 nets.
