milanovviktorio/harbor-measuring-device-SPRO3/(commit log)

2025-10-13 platform example for pico under arduino
2025-10-19 Add files via upload
    a added bare minimum. NOTE it's will be noisy as fuck make sure to put caps as close to mcu as possible avoid cables use net zones;))
2025-10-21 Started developing the Main PCB
    [ICM-42688-P.step, Main_PCB.kicad_pcb, Main_PCB.kicad_sch, TUSS4470TRTJT.step, rp2040.kicad_sch, sonar.kicad_sch]
2025-10-22 Added Buck and Boost converter as well as a basic RP2040 circuit
    [Main_PCB.kicad_sch, RP2040_minimal_r2-BOM.xlsx, RP2040_minimal_r2.kicad_pcb, RP2040_minimal_r2.kicad_sch, TPS61175PWPR.step, sonar.kicad_sch]
2025-10-22 Fixed stupid things on the boost converter
    [Main_PCB.kicad_sch]
2025-10-24 Made the simulations for the Main PCB
2025-10-26 Trustworthy version of the MAIN PCB schematic
    [Main_PCB.kicad_sch, rp2040.kicad_sch, sonar.kicad_sch]
2025-10-26 fixed folder struct
    [1.ECS.kicad_sch, 2.BMS.kicad_sch, 3.Connectors.kicad_sch, BMS.kicad_sch, Connectors.kicad_sch, RP2040_minimal_r2-BOM.xlsx, RP2040_minimal_r2.kicad_pcb, RP2040_minimal_r2.kicad_sch]
2025-10-26 Updated to match connectors from ESC/BMS board, other corrections
    [Main_PCB.kicad_sch]
2025-10-26 RF test on pico sdk
2025-10-28 Added some footprints
    [Main_PCB.kicad_sch, SRR6038-100Y.step, rp2040.kicad_sch, sonar.kicad_sch]
2025-10-28 Updated SPROJ3EE_ESC_BMS.kicad_sch to include more caps
2025-10-28 Updated 1.ECS.kicad_sch to put more caps and fix some nets
    [1.ECS.kicad_sch]
2025-10-28 Updated 2.BMS.kicad_sch to add bulk capacitance
    [2.BMS.kicad_sch]
2025-10-29 initial BMS work
    [1.ECS.kicad_sch, 2.BMS.kicad_sch, 3.Connectors.kicad_sch, SPROJ3EE_ESC_BMS.kicad_sch]
2025-10-30 Modifications to the MainPCB
    [ICM42688.kicad_sch, Main_PCB.kicad_sch, Power_supplies.kicad_sch, rp2040.kicad_sch]
2025-10-30 Updated sonar.kicad_sch with a new sonar connector
    [sonar.kicad_sch]
2025-10-30 Updated Main_PCB.kicad_sch with servo connector
    [Main_PCB.kicad_sch]
2025-10-30 A finished version of the Main PCB schematic
    [ICM42688.kicad_sch, Main_PCB.kicad_sch, Power_supplies.kicad_sch, connections.kicad_sch, rp2040.kicad_sch, sonar.kicad_sch]
2025-10-31 Added footprints to all components
    [ICM42688.kicad_sch, Main_PCB.kicad_sch, Power_supplies.kicad_sch, connections.kicad_sch, rp2040.kicad_sch, sonar.kicad_sch]
2025-10-31 some more BMS work + fixed RP2040 XIN/XOUT shortage
    [2.BMS.kicad_sch, RP2040_minimal_r2.kicad_sch, SPROJ3EE_ESC_BMS.kicad_sch]
2025-11-01 Finished the schematic of the MainPCB
    [Main_PCB.kicad_pcb, Main_PCB.kicad_sch, Power_supplies.kicad_sch, connections.kicad_sch, rp2040.kicad_sch, sonar.kicad_sch]
2025-11-01 start adding RC PCB bits (not finished at all)
    [RC thing.kicad_pcb, RC thing.kicad_sch, rp2040.kicad_sch]
2025-11-02 Some footprint positioning
    [Main_PCB.kicad_pcb]
2025-11-02 RC thing schematic 70% done
    [RC thing.kicad_sch, bms.kicad_sch, rp2040.kicad_sch]
2025-11-04 BMS almost full
    [2.BMS.kicad_sch, SPROJ3EE_ESC_BMS.kicad_sch]
2025-11-04 more rc stuff (trust)
    [RC thing.kicad_sch, bms.kicad_sch]
2025-11-05 more BMS
    [2.BMS.kicad_sch, 3.Connectors.kicad_sch, SPROJ3EE_ESC_BMS.kicad_sch, TPS259260DRC_TRANS.OLB, TPS259260_TRANS.DSN, TPS259260_TRANS.OPJ]
2025-11-05 Placement almost complete on MainPCB
    [Main_PCB.kicad_pcb, Power_supplies.kicad_sch]
2025-11-06 Probably a final version of the MAIN PCB component placement
    [Main_PCB.kicad_pcb, Power_supplies.kicad_sch, UJC-HP-3-SMT-TR.step, connections.kicad_sch, rp2040.kicad_sch]
2025-11-06 fixed voltage divider for controller batt status
    [bms.kicad_sch]
2025-11-06 Made the power supply planes and traces
    [Main_PCB.kicad_pcb]
2025-11-07 Work on the PCB
    [Main_PCB.kicad_pcb]
2025-11-07 Finished the routing - V1
    [Main_PCB.kicad_pcb]
2025-11-07 Updated the PCB with new USB-C
    [Main_PCB.kicad_pcb, rp2040.kicad_sch]
2025-11-08 Simulations for BMS start and footprints
    [1.ECS.kicad_sch, 2.BMS.kicad_sch, 3.Connectors.kicad_sch, DXF_ESCBMS.dxf, SPROJ3EE_ESC_BMS.kicad_sch]
2025-11-09 Footprints + final schematic _/\_
    [2.BMS.kicad_sch, SPROJ3EE_ESC_BMS.kicad_pcb]
2025-11-10 footprints almost done and LEDs for charger fixed
    [2.BMS.kicad_sch]
2025-11-10 update pin layout to make PCB easier
    [RC thing.kicad_sch]
2025-11-11 G is too lazy to upload his schematic
    [RC thing.kicad_pcb, RC thing.kicad_sch, bms.kicad_sch, rp2040.kicad_sch]
2025-11-11 more pinout changes :upside_down_smile:
    [RC thing.kicad_sch]
2025-11-11 ESC/BMS fully ready for PCB
    [2.BMS.kicad_sch, 3.Connectors.kicad_sch]
2025-11-11 V1.1 of the MainPCB
    [Main_PCB.kicad_pcb, Power_supplies.kicad_sch, rp2040.kicad_sch, sonar.kicad_sch]
2025-11-12 Should be finished version of MainPCB - v2
    [Main_PCB.kicad_pcb]
2025-11-12 Finished MainPCB v3
    [Main_PCB.kicad_pcb, Power_supplies.kicad_sch, connections.kicad_sch, rp2040.kicad_sch]
2025-11-12 Small adjustment to top silkscreen on MainPCB
    [Main_PCB.kicad_pcb]
2025-11-12 ESC/BMS PCB started
    [1.ECS.kicad_sch, 3.Connectors.kicad_sch, SPROJ3EE_ESC_BMS.kicad_pcb]
2025-11-13 PCB component placement init
    [2.BMS.kicad_sch, SPROJ3EE_ESC_BMS.kicad_pcb]
2025-11-13 the G-ening
    [RC thing-B_Cu.gbr, RC thing-B_Mask.gbr, RC thing-B_Paste.gbr, RC thing-B_Silkscreen.gbr, RC thing-Edge_Cuts.gbr, RC thing-F_Cu.gbr, RC thing-F_Mask.gbr, RC thing-F_Paste.gbr]
2025-11-13 cleanup 2
    [RC thing.kicad_pcb, RC thing.kicad_sch, bms.kicad_sch]
2025-11-13 current state of Rc
    [RC thing.kicad_pcb, RC thing.kicad_sch, bms.kicad_sch, rp2040.kicad_sch]
2025-11-13 ESC BMS component placement close to done
    [2.BMS.kicad_sch, 3.Connectors.kicad_sch, SPROJ3EE_ESC_BMS.kicad_pcb, SPROJ3EE_ESC_BMS.kicad_sch]
2025-11-13 RC thing PCB 95% trustworthy (six seven)
    [RC thing-B_Cu.gbr, RC thing-B_Mask.gbr, RC thing-B_Paste.gbr, RC thing-B_Silkscreen.gbr, RC thing-Edge_Cuts.gbr, RC thing-F_Cu.gbr, RC thing-F_Mask.gbr, RC thing-F_Paste.gbr]
2025-11-14 ESC done
    [2.BMS.kicad_sch, 3.Connectors.kicad_sch, SPROJ3EE_ESC_BMS.kicad_pcb, SPROJ3EE_ESC_BMS.kicad_sch]
2025-11-15 new RC PCB updates
    [RC thing.kicad_pcb, RC thing.kicad_sch, bms.kicad_sch, rp2040.kicad_sch]
2025-11-15 G will be touched tonight
    [RC thing-B_Cu.gbr, RC thing-B_Mask.gbr, RC thing-B_Paste.gbr, RC thing-B_Silkscreen.gbr, RC thing-Edge_Cuts.gbr, RC thing-F_Cu.gbr, RC thing-F_Mask.gbr, RC thing-F_Paste.gbr]
2025-11-16 Changed the IMU sensor on the MainPCB
    [ICM42688.kicad_sch, Main_PCB.kicad_pcb]
2025-11-16 Minor adjustments to MainPCB
    [ICM42688.kicad_sch, Main_PCB.kicad_pcb, Main_PCB.kicad_sch]
2025-11-16 ESC/BMS board done _/\_ (without silkscreen)
    [SPROJ3EE_ESC_BMS.kicad_pcb]
2025-11-17 ESC/BMS board done _/\_ (with full silkscreen) - just 12 warnings
    [SPROJ3EE_ESC_BMS.kicad_pcb]
2025-11-17 Light rework of ESC/BMS layout
    [2.BMS.kicad_sch, SPROJ3EE_ESC_BMS.kicad_pcb]
2025-11-17 Reviewed .sch
    [RC thing.kicad_pcb, bms.kicad_sch, rp2040.kicad_sch]
2025-11-17 trustworthy(?) RC PCB
    [RC thing.kicad_pcb, RC thing.kicad_sch]
2025-11-17 ESC/BMS board done fully
    [2.BMS.kicad_sch, SPROJ3EE_ESC_BMS.kicad_pcb]
2025-11-17 ESC/BMS board done fully fully
    [1.ECS.kicad_sch, 2.BMS.kicad_sch, SPROJ3EE_ESC_BMS.kicad_pcb]
2025-11-17 ESC/BMS board done fully fully fully
    [SPROJ3EE_ESC_BMS.kicad_pcb]
2025-11-18 Reverted to the previous IMU
    [ICM42688.kicad_sch, Main_PCB.kicad_pcb, Main_PCB.kicad_sch]
2025-11-18 fixing DRC errors on RC
    [RC thing.kicad_pcb]
2025-11-18 Small adjustments
    [SPROJ3EE_ESC_BMS.kicad_pcb, SPROJ3EE_ESC_BMS.kicad_sch]
2025-11-18 Stitching GND, silkscreen thickness, increased thermal distribution of charger IC
    [ICM42688.kicad_sch, RC thing.kicad_pcb]
2025-11-18 Footprint updated
    [ICM42688.kicad_sch, Main_PCB.kicad_pcb, Main_PCB.kicad_sch, rp2040.kicad_sch]
2025-11-18 little pin change in software
2025-11-18 MainPCB Final version
    [Main_PCB.kicad_pcb]
2025-11-18 ESC/BMS board with SDU logo (slick)
    [SPROJ3EE_ESC_BMS.kicad_pcb]
2025-11-18 Final touches
    [Main_PCB.kicad_pcb, RC thing.kicad_pcb, RC thing.kicad_sch, SPROJ3EE_ESC_BMS.kicad_pcb, bms.kicad_sch, rp2040.kicad_sch]
2025-12-03 pico project start for main pcb
2025-12-04 started implementing motor driver code
2025-12-04 more motor stuff (now arduino'd)
2025-12-10 IMU code fully working
2025-12-10 IMU code small pin adjustment and Servo motor swinging code
2025-12-10 Made a skeleton for the Main PCB code
2025-12-10 BLDC code that actually works as it should
2025-12-14 some sonar functions + some basics for RF (main doesn't compile rn)
    [RC_PCB_fw.ino, main_PCB_fw.ino]
2025-12-15 main PCB work. TUSS code might work (doubtful)
2025-12-16 RF transmit/receive. Works until whining happens. Fixable. Trust.
    [RF_Receive.ino, RF_Transmit.ino]
2025-12-17 Some sonar code. Unreliable in air, idk bout water
2025-12-20 Minor adjustments to BMS schematic - beautifying
    [2.BMS.kicad_sch]
2025-12-22 Beautifying the Master Controller
    [ICM42688.kicad_sch, Main_PCB.kicad_sch, Power_supplies.kicad_sch, connections.kicad_sch, rp2040.kicad_sch, sonar.kicad_sch]
2026-01-22 more stuff (ESC exploded)
2026-01-25 fixed vprot and gnd comp error
    [1.ECS.kicad_sch]
2026-01-25 fixed drain and source error bms
    [1.ECS.kicad_sch, 2.BMS.kicad_sch]
2026-01-27 final plate of spaghetti
    kill me
